Froggy111/RBC-soccer-2025/README.md

# RBC-soccer-2025

(Currently internal) Repository for 2025 RCJ Soccer Lightweight team from RI.

Other Links:
- Component spreadsheet: https://docs.google.com/spreadsheets/d/1nkJU1fMwBykuh6vTQhCEh5VCzHdAhULuCZyUjWnpDP0/edit#gid=0
