Froggy111/RBC-soccer-2025/hardware/mirror/README.md

# Mirror Generator

generate slice:
```./main.o 80 150 2430 30 10000 100 1 1000 1000```
generate stl:
```./src/main.o 80 150 2430 30 100 1000 1 100 mirror.stl generated_by_mirror```

Numerical solver for mirror geometry. Generates mirror stl (TODO: add an inset to make it a proper mirror mold)
