Froggy111/RBC-soccer-2025/software/top/README.md

# top PCB firmware

## project structure

drivers/libraries are in libs/
main executables are in src/
tests of drivers/libraries/basic functionality are in tests/
configs are in configs/

## used libraries

- PicoSDK
- TinyUSB
- FreeRTOS
