Froggy111/RBC-soccer-2025/software/middle/goalpost_detection/blue1.png

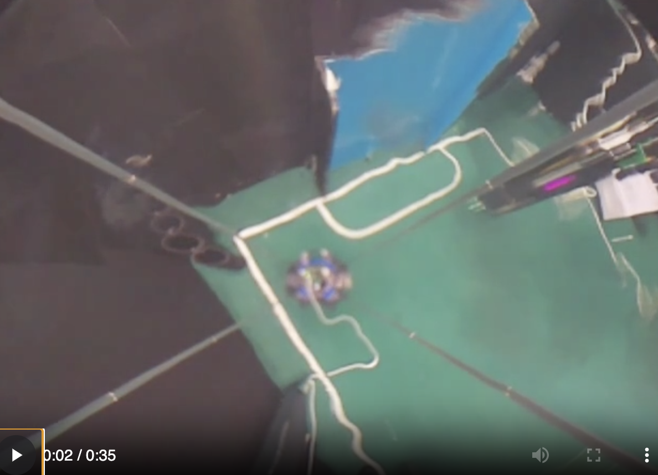
software/middle/goalpost_detection/blue1.png
