Froggy111/RBC-soccer-2025/software/rpi-direct/field.png

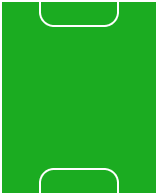
software/rpi-direct/field.png
