Froggy111/RBC-soccer-2025/hardware/lightgate/pcb/pcb.step

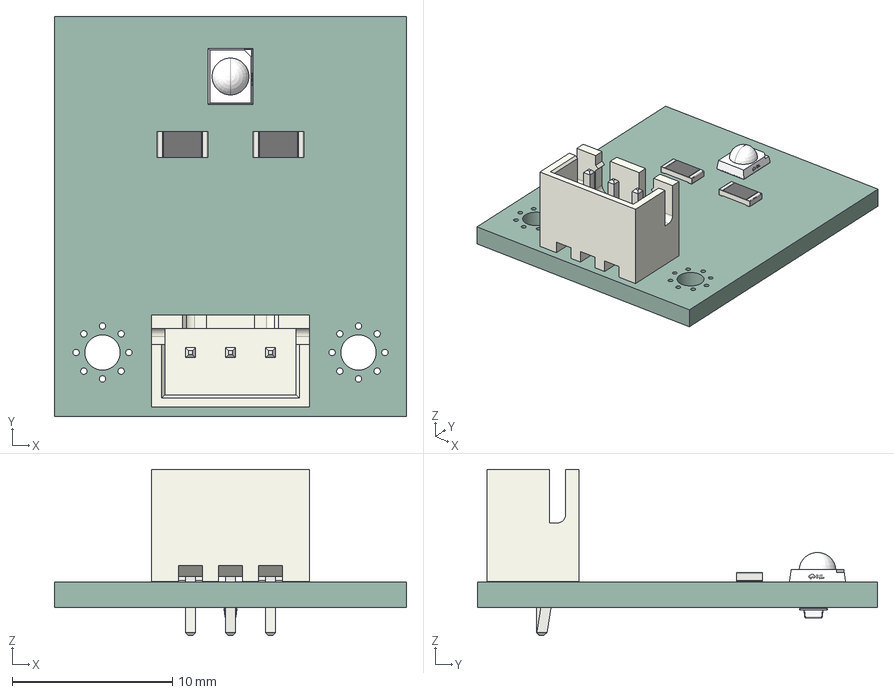
[picture p7: CAD file, 2025-02-17]
hardware/lightgate/pcb/pcb.step
22.0 x 25.0 x 10.4 mm
LED-SMD_L3.5-W2.8_JNJ-LTJH0111W60
R_1206_3216Metric x 2
JST_B3B_XH_A
SENSORS-SMD_L1.7-W0.8-H0.6
pcb_PCB
