Froggy111/RBC-soccer-2025/hardware/mouse-sensor/pcb/pcb-Edge_Cuts.dxf

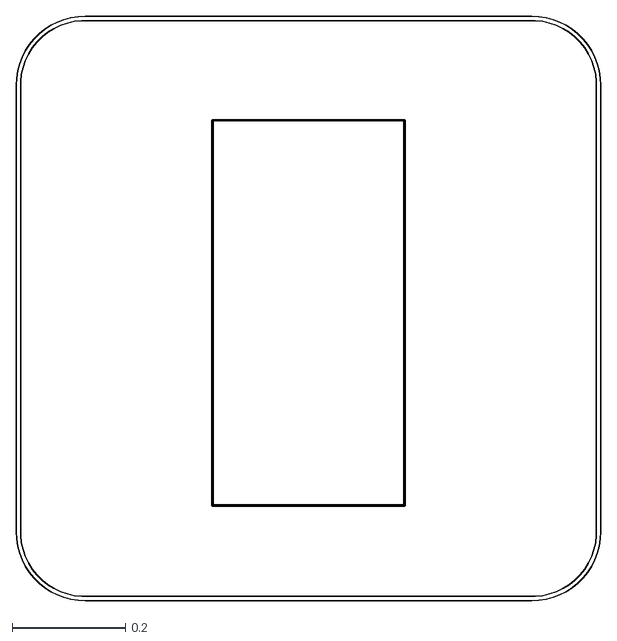
[picture p8: CAD file, 2024-12-10]
hardware/mouse-sensor/pcb/pcb-Edge_Cuts.dxf
1.03 x 1.03
