Froggy111/RBC-soccer-2025/hardware/ultrasound/pcb/pcb.step

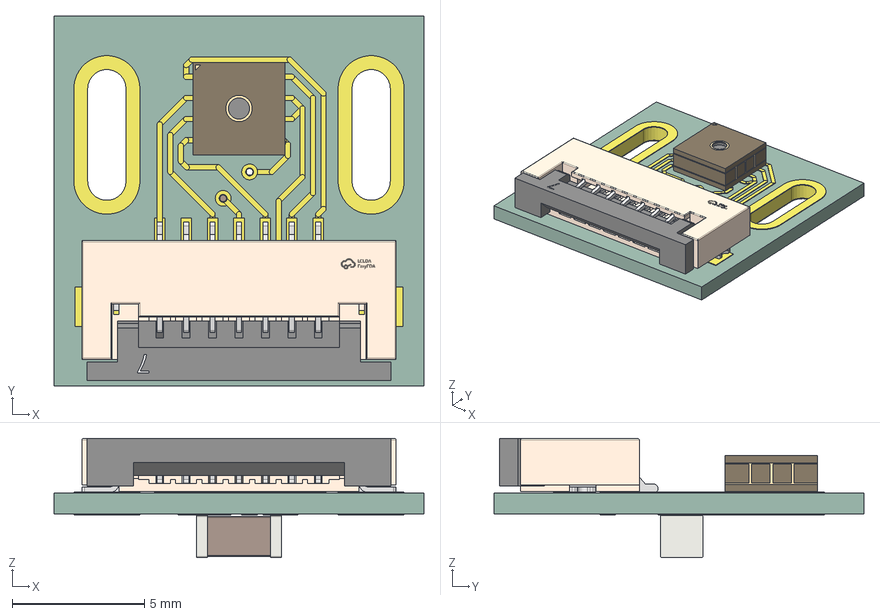
[picture p9: CAD file, 2025-01-07]
hardware/ultrasound/pcb/pcb.step
14.0 x 14.0 x 4.51 mm
CH201-00ABR
FPC-SMD_7P-P1.0_KINGHELM_KH-FG1.0-H2.0-7PIN
C_1206_3216Metric
pcb_track_1
pcb_track_2
pcb_track_3
pcb_track_4
pcb_track_5
pcb_track_6
pcb_track_7
pcb_track_8
pcb_track_9
pcb_track_10
pcb_track_11
pcb_track_12
pcb_track_13
pcb_track_14
pcb_track_15
pcb_track_16
pcb_track_17
pcb_track_18
pcb_track_19
pcb_track_20
pcb_track_21
pcb_track_22
pcb_track_23
pcb_track_24
pcb_track_25
pcb_track_26
pcb_track_27
pcb_track_28
pcb_track_29
pcb_track_30
pcb_track_31
pcb_track_32
pcb_track_33
pcb_track_34
pcb_track_35
pcb_track_36
pcb_track_37
pcb_track_38
pcb_track_39
pcb_track_40
pcb_track_41
pcb_track_42
pcb_track_43
pcb_track_44
pcb_track_45
pcb_track_46
pcb_track_47
pcb_track_48
pcb_pad_1
pcb_pad_2
pcb_pad_3
pcb_pad_4
pcb_pad_5
pcb_pad_6
pcb_pad_7
pcb_pad_8
pcb_pad_9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
