Froggy111/RBC-soccer-2025/TODO.md

**THIS IS QUITE USELESS. JUST HERE TO PRESERVE STRUCTURE OF THIS REPO**

TBC = have not thought about enough yet to have a solid plan. Fill up in the future.
**THIS IS A REMINDER TO FILL UP IF YOU ARE LOOKING AT THIS, IF YOU CAN**

**REFER TO SUBDIRs FOR SPECIFICS.**

Thread 1:
- Do hardware tests, prototype seperate parts (refer to hardware TODO).

Thread 2:
- Design software structure, write code (refer to software TODO).
