Froggy111/RBC-soccer-2025/software/TODO.md

TBC = have not thought about enough yet to have a solid plan. Fill up in the future.
<ins>**_THIS IS A REMINDER TO FILL UP IF YOU ARE LOOKING AT THIS, IF YOU CAN_**</ins>

<ins>**Mostly completed:**</ins>

<ins>**Incomplete:**</ins>
**(TBC) Thread 1:**
- Hardware interfacing

**(TBC) Thread 2:**
- Hardware data to useful software data (algos, can do first)

**(TBC) Thread 3:**
- Strategy (can also do first)
