Froggy111/RBC-soccer-2025/hardware/lightgate/pcb/pcb.kicad_pcb

## KiCad design hardware/lightgate/pcb/pcb.kicad_pcb (2025-02-17)

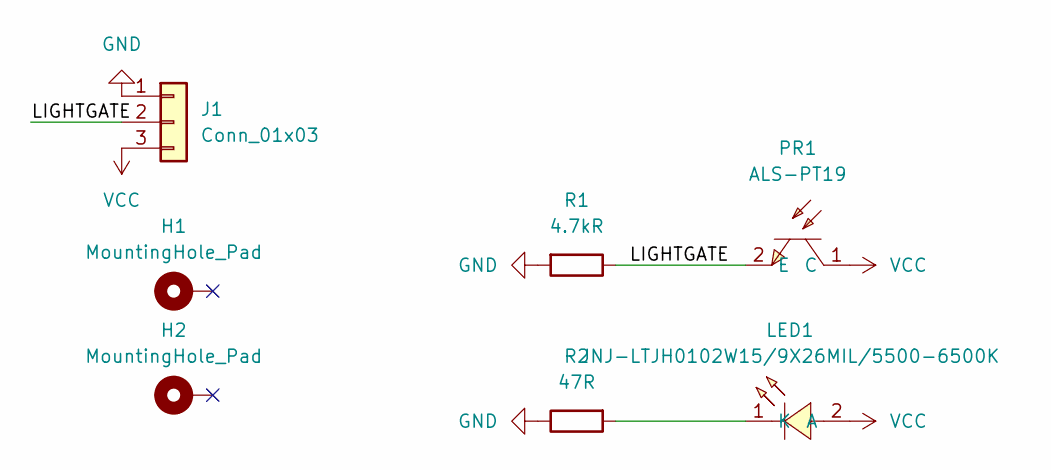
[picture p10: schematic pcb.kicad_sch]

Parts:
H1, H2: MountingHole_Pad; MountingHole_2.2mm_M2_Pad_Via
J1: Conn_01x03; JST_XH_B3B-XH-A_1x03_P2.50mm_Vertical
LED1: JNJ-LTJH0102W15/9X26MIL/5500-6500K; LED-SMD_L3.5-W2.8_JNJ-LTJH0111W60; LCSC Part C7500117
PR1: ALS-PT19; SENSORS-SMD_ALS-PT19; LCSC Part C146233
R1: 4.7kR; R_1206_3216Metric_Pad1.30x1.75mm_HandSolder
R2: 47R; R_1206_3216Metric_Pad1.30x1.75mm_HandSolder

Connections:
/LIGHTGATE: J1.2, PR1.2 (E), R1.1
GND: J1.1, R1.2, R2.1
unnamed: LED1.1 (K), R2.2
VCC: J1.3, LED1.2 (A), PR1.1 (C)

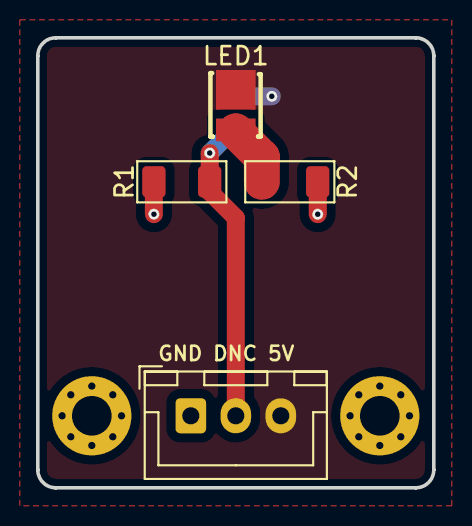
[picture p11: board hardware/lightgate/pcb/pcb.kicad_pcb from above]

Board: 2 copper layers, 22.0 x 25.0 mm, 7 parts (1 on the bottom side), 4 nets.
