Froggy111/RBC-soccer-2025/hardware/kicker/pcb/pcb.kicad_pcb

## KiCad design hardware/kicker/pcb/pcb.kicad_pcb (2025-02-16)

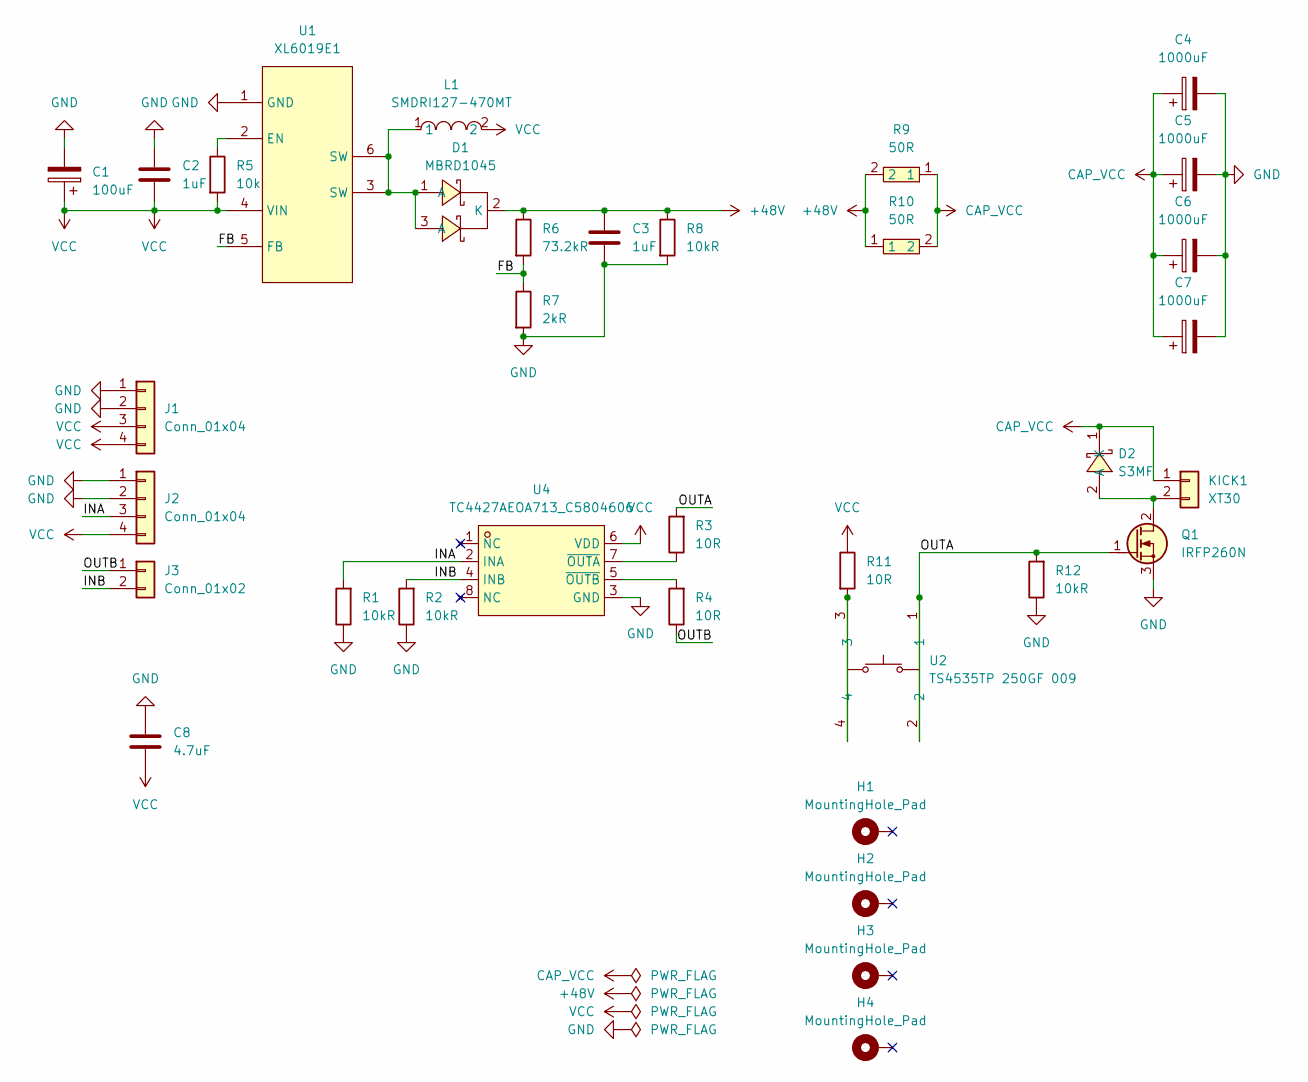
[picture p12: schematic pcb.kicad_sch]

Parts:
C1: 100uF; CP_Elec_6.3x7.7
C2, C3: 1uF; C_1206_3216Metric_Pad1.33x1.80mm_HandSolder
C4, C5, C6, C7: 1000uF; CAP-TH_BD13.0-P5.00-D1.2-FD
C8: 4.7uF; C_1206_3216Metric_Pad1.33x1.80mm_HandSolder
D1: MBRD1045; TO-252-3_L6.5-W5.9-P4.60-LS10.0-BL; LCSC Part C5137764
D2: S3MF; SMAF_L3.5-W2.6-LS4.7-RD-1; LCSC Part C18199092
H1, H2, H3, H4: MountingHole_Pad; MountingHole_2.2mm_M2_Pad_Via
J1, J2: Conn_01x04; PinHeader_1x04_P2.54mm_Vertical
J3: Conn_01x02; JST_PH_B2B-PH-K_1x02_P2.00mm_Vertical
KICK1: XT30; AMASS_XT30U-F_1x02_P5.0mm_Vertical
L1: SMDRI127-470MT; IND-SMD_L12.3-W12.3; LCSC Part C9906
Q1: IRFP260N; TO-247-3_Vertical_GDS
R1, R2, R8, R12: 10kR; R_1206_3216Metric_Pad1.30x1.75mm_HandSolder
R3, R4, R11: 10R; R_1206_3216Metric_Pad1.30x1.75mm_HandSolder
R5: 10k; R_1206_3216Metric_Pad1.30x1.75mm_HandSolder
R6: 73.2kR; R_1206_3216Metric_Pad1.30x1.75mm_HandSolder
R7: 2kR; R_1206_3216Metric_Pad1.30x1.75mm_HandSolder
R9, R10: 50R; TO-220-2L_L10.2-W4.6-P5.08-L; LCSC Part C5209737
U1: XL6019E1; TO-263-5_L10.2-W9.9-P1.70-LS14.4-TL; LCSC Part C73018
U2: TS4535TP 250GF 009; SW-SMD_4P-L4.5-W4.5-P3.00-LS6.8; LCSC Part C5342982
U4: TC4427AEOA713_C5804606; SOIC-8_L4.9-W3.9-P1.27-LS6.0-BL; LCSC Part C5804606

Connections:
+48V: C3.1, D1.2 (K), R6.1, R8.1, R9.2, R10.1
/FB: R6.2, R7.1, U1.5 (FB)
/INA: J2.3, R1.2, U4.2 (INA)
/INB: J3.2, R2.2, U4.4 (INB)
/OUTA: Q1.1 (G), R3.2, R12.2, U2.1, U2.2
/OUTB: J3.1, R4.1
CAP_VCC: C4.1, C5.1, C6.1, C7.1, D2.1 (K), KICK1.1, R9.1, R10.2
GND: C1.2, C2.1, C3.2, C4.2, C5.2, C6.2, C7.2, C8.1, J1.1, J1.2, J2.1, J2.2, Q1.3 (S), R1.1, R2.1, R7.2, R8.2, R12.1, U1.1 (GND), U4.3 (GND)
unnamed: D1.1 (A), D1.3 (A), L1.1, U1.3 (SW), U1.6 (SW)
unnamed: D2.2 (A), KICK1.2, Q1.2 (D)
unnamed: R11.2, U2.3, U2.4
unnamed: R5.1, U1.2 (EN)
unnamed: R3.1, U4.7 (~OUTA)
unnamed: R4.2, U4.5 (~OUTB)
VCC: C1.1, C2.2, C8.2, J1.3, J1.4, J2.4, L1.2, R5.2, R11.1, U1.4 (VIN), U4.6 (VDD)

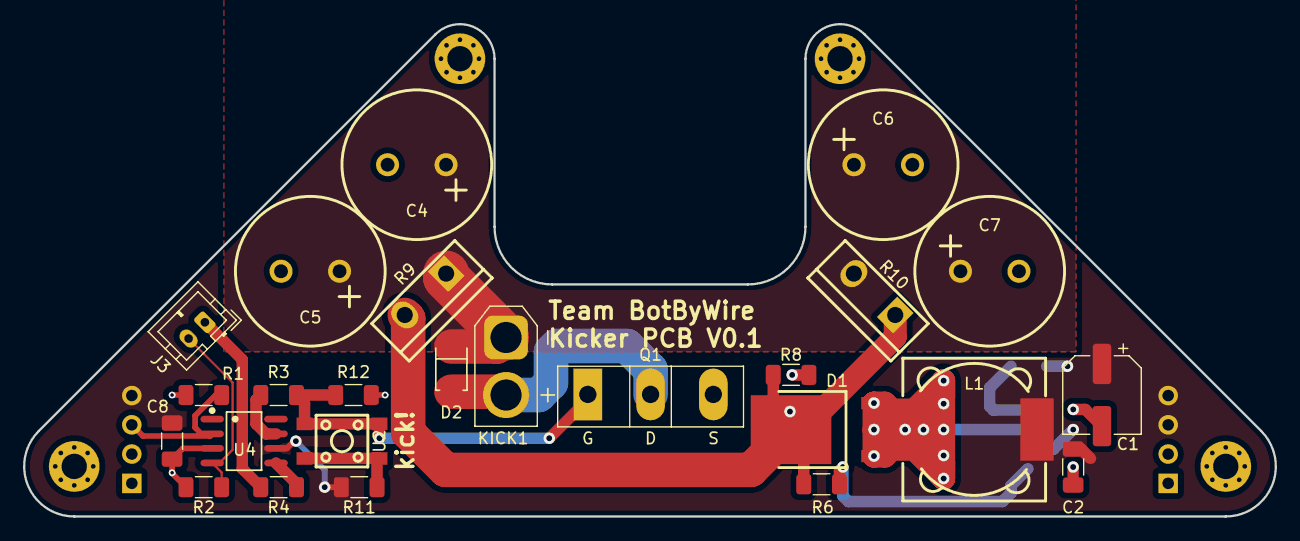
[picture p13: board hardware/kicker/pcb/pcb.kicad_pcb from above]

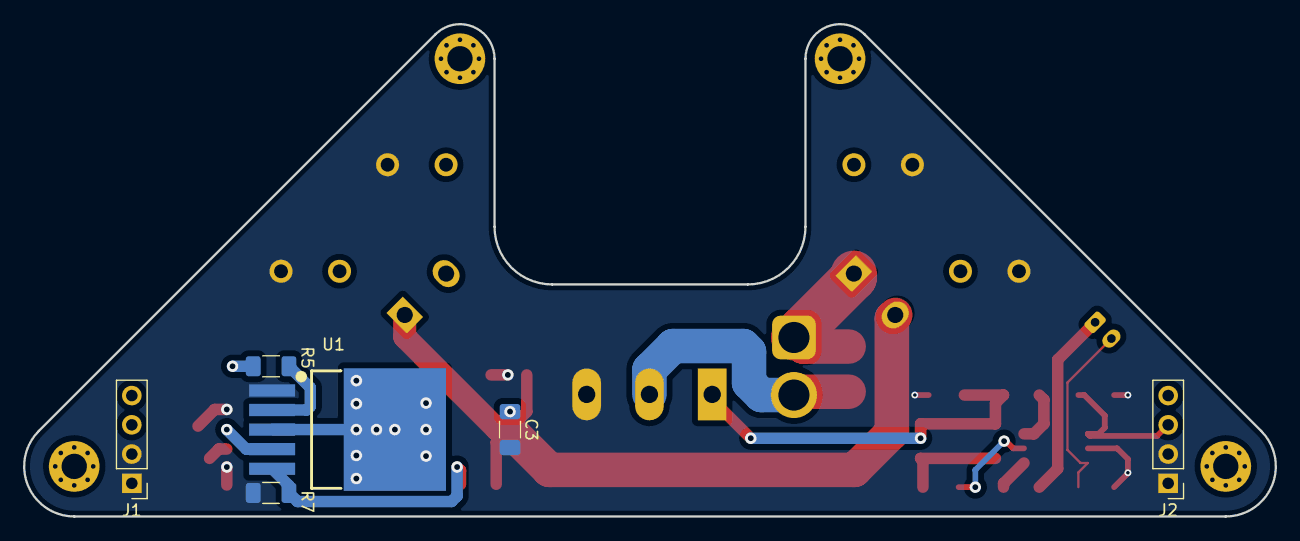
[picture p14: board hardware/kicker/pcb/pcb.kicad_pcb from below]

Board: 2 copper layers, 108.7 x 42.8 mm, 35 parts (6 on the bottom side), 15 nets.
