Froggy111/RBC-soccer-2025/hardware/top-plate/pcb/pcb.kicad_pcb

## KiCad design hardware/top-plate/pcb/pcb.kicad_pcb (2025-02-08)

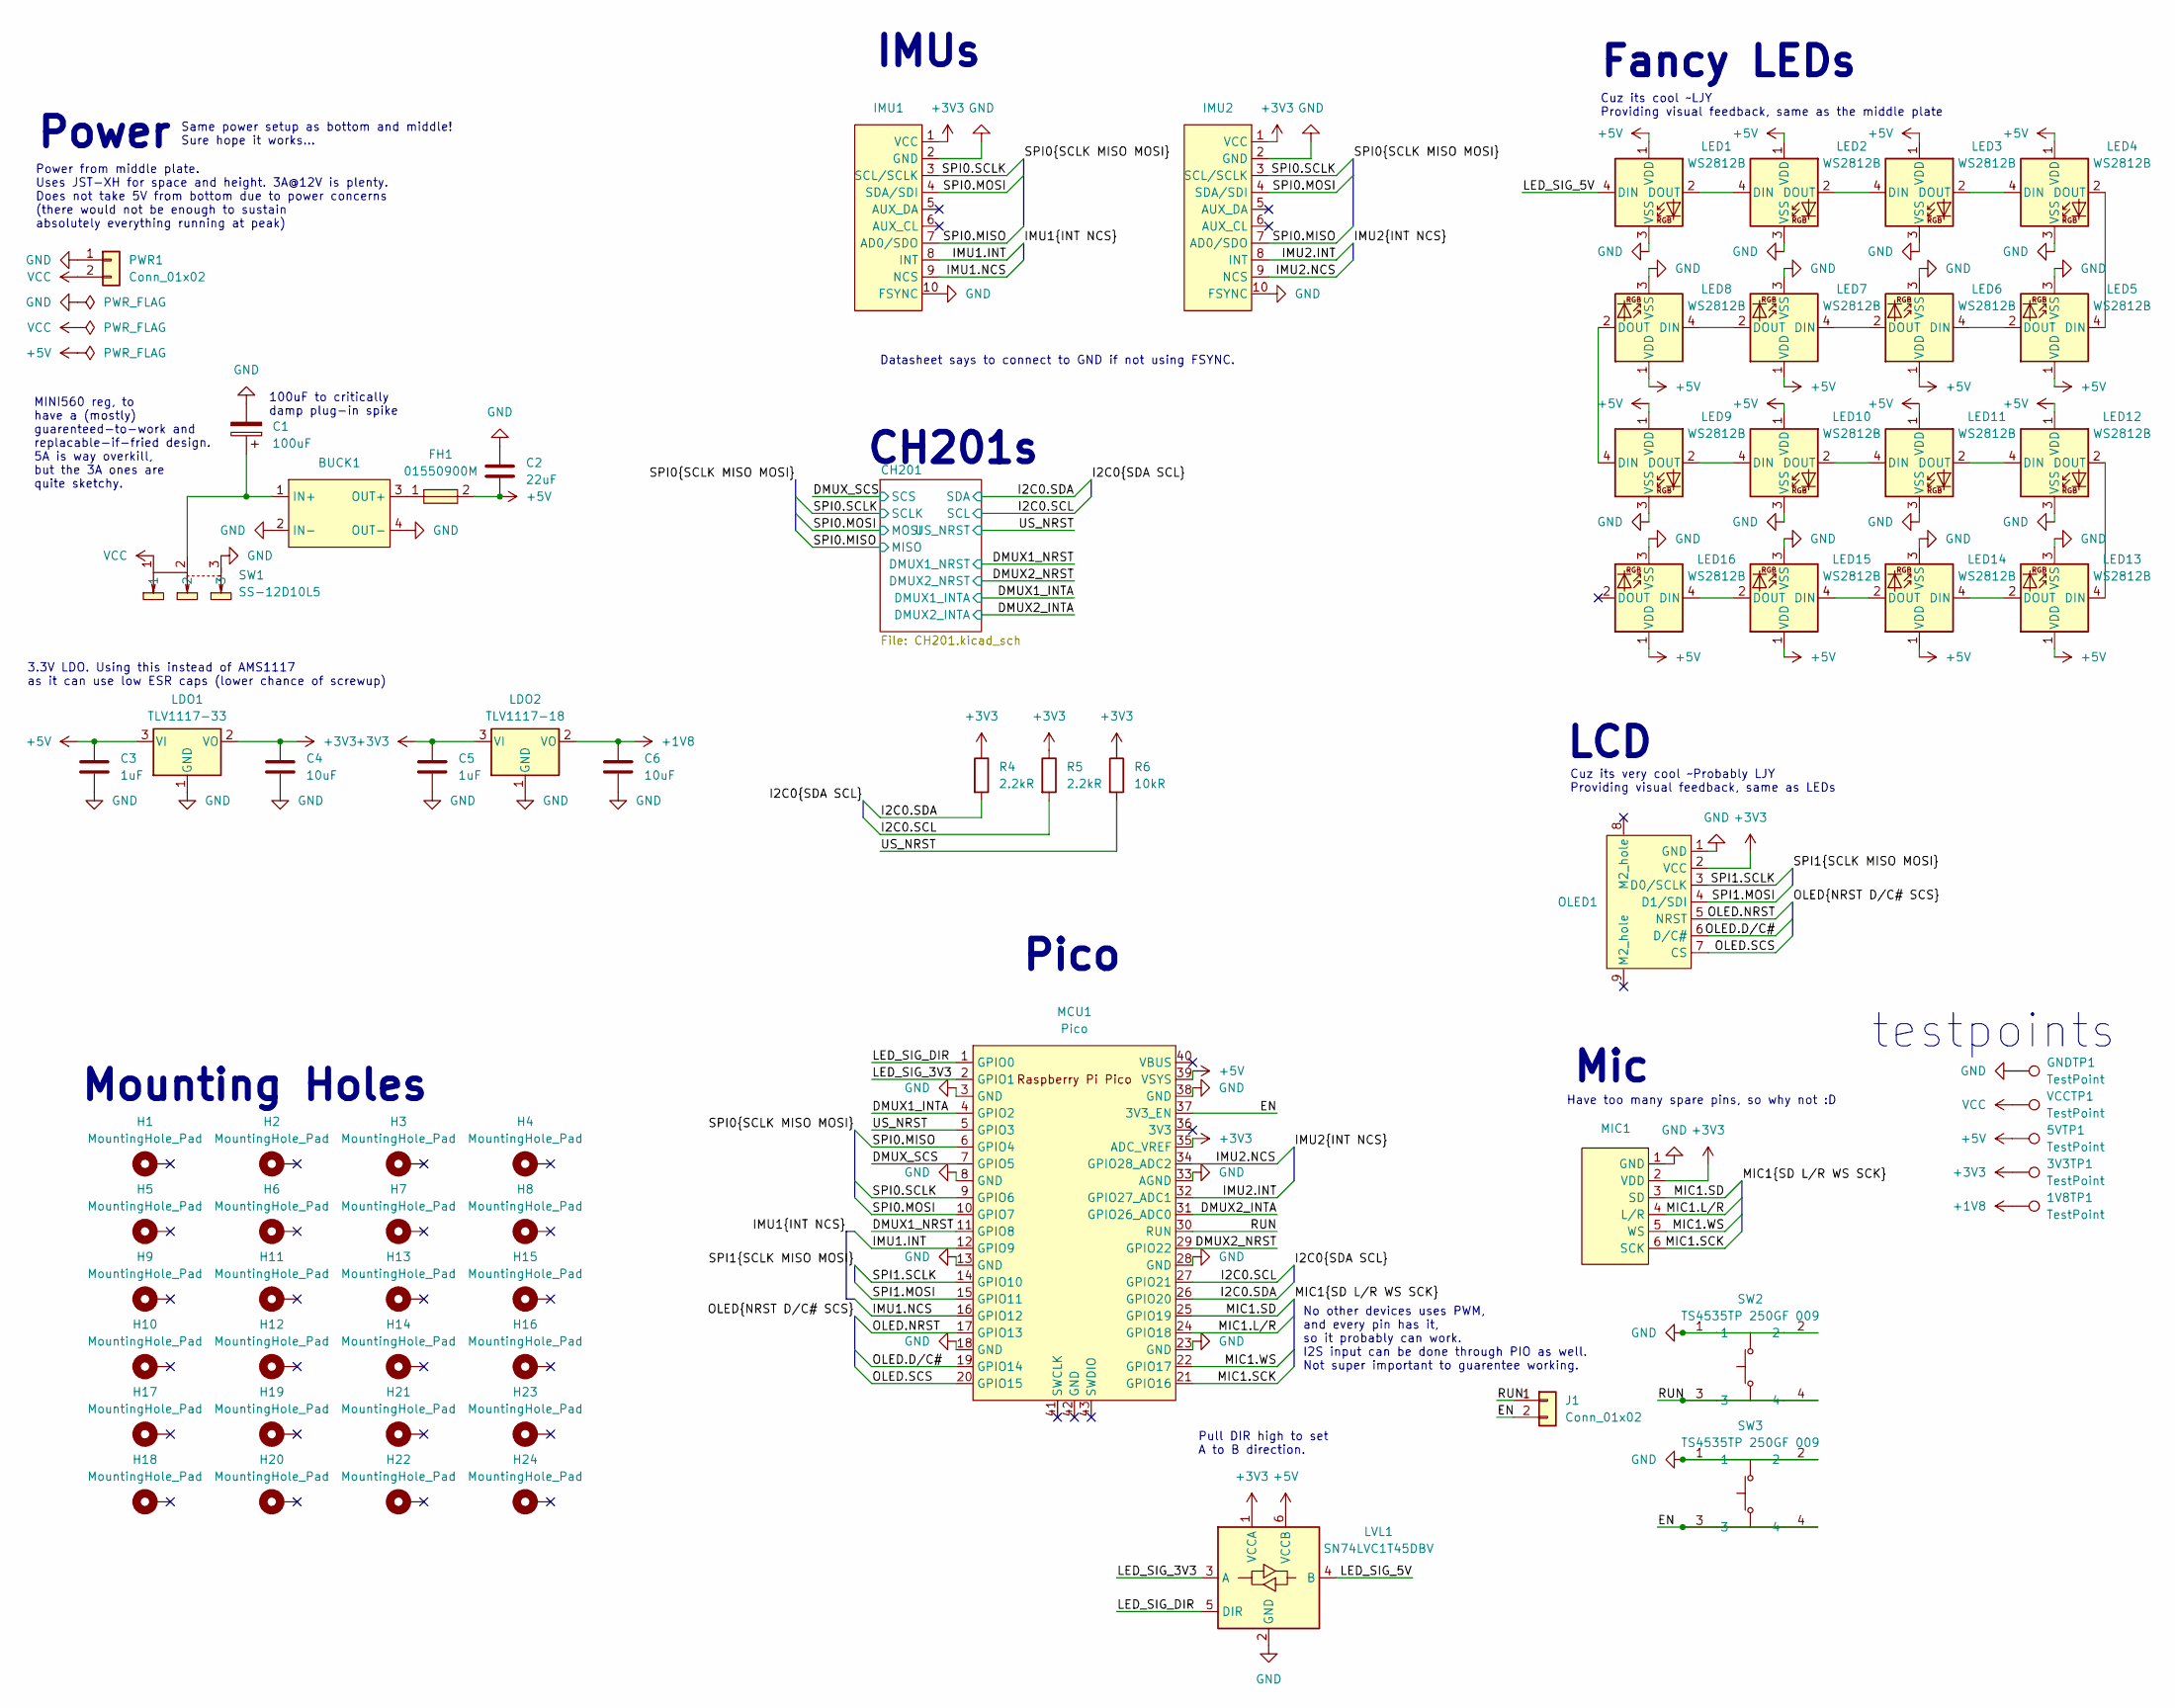
[picture p15: schematic pcb.kicad_sch]

Parts:
1V8TP1, 3V3TP1, 5VTP1: TestPoint; TestPoint_THTPad_D1.0mm_Drill0.5mm
BUCK1: mini560
C1: 100uF; CP_Elec_6.3x7.7
C2: 22uF; C_0805_2012Metric_Pad1.15x1.40mm_HandSolder
C3, C5: 1uF; C_0805_2012Metric_Pad1.15x1.40mm_HandSolder
C4, C6: 10uF; C_0805_2012Metric_Pad1.15x1.40mm_HandSolder
FH1: 01550900M; FUSE-SMD_L9.8-W5.0; LCSC Part C108518
GNDTP1: TestPoint; TestPoint_THTPad_D1.0mm_Drill0.5mm
H1, H2, H3, H4, H5, H6, H7, H8, H9, H10, H11, H12, H13, H14, H15, H16, H17, H18, H19, H20, H21, H22, H23, H24: MountingHole_Pad; MountingHole_2.2mm_M2_Pad_Via
IMU1, IMU2: ICM20948-no-mountingholes
J1: Conn_01x02; JST_XH_B2B-XH-A_1x02_P2.50mm_Vertical
LDO1: TLV1117-33; SOT-223-3_TabPin2
LDO2: TLV1117-18; SOT-223-3_TabPin2
LED1, LED2, LED3, LED4, LED5, LED6, LED7, LED8, LED9, LED10, LED11, LED12, LED13, LED14, LED15, LED16: WS2812B; LED_WS2812B_PLCC4_5.0x5.0mm_P3.2mm
LVL1: SN74LVC1T45DBV; SOT-23-6
MCU1: Pico; RPi_Pico_SMD_TH_USBC_cable_cutout
MIC1: INMP441_SMD
OLED1: 0.96-inch_OLED_7-no-back-mountingholes
PWR1: Conn_01x02; JST_XH_B2B-XH-A_1x02_P2.50mm_Vertical
R4, R5: 2.2kR; R_0805_2012Metric_Pad1.15x1.40mm_HandSolder
R6: 10kR; R_0805_2012Metric_Pad1.15x1.40mm_HandSolder
SW1: SS-12D10L5; SW-TH_SS-12D10L5; LCSC Part C319012
SW2, SW3: TS4535TP 250GF 009; SW-SMD_4P-L4.5-W4.5-P3.00-LS6.8; LCSC Part C5342982
VCCTP1: TestPoint; TestPoint_THTPad_D1.0mm_Drill0.5mm

Connections:
+1V8: 1V8TP1.1, C6.2, LDO2.2 (VO); also elsewhere on the board
+3V3: 3V3TP1.1, C4.2, C5.2, IMU1.1 (VCC), IMU2.1 (VCC), LDO1.2 (VO), LDO2.3 (VI), LVL1.1 (VCCA), MCU1.35 (ADC_VREF), MIC1.2 (VDD), OLED1.2 (VCC), R4.1, R5.1, R6.1; also elsewhere on the board
+5V: 5VTP1.1, C2.2, C3.2, FH1.2, LDO1.3 (VI), LED1.1 (VDD), LED2.1 (VDD), LED3.1 (VDD), LED4.1 (VDD), LED5.1 (VDD), LED6.1 (VDD), LED7.1 (VDD), LED8.1 (VDD), LED9.1 (VDD), LED10.1 (VDD), LED11.1 (VDD), LED12.1 (VDD), LED13.1 (VDD), LED14.1 (VDD), LED15.1 (VDD), LED16.1 (VDD), LVL1.6 (VCCB), MCU1.39 (VSYS)
/DMUX1_INTA: MCU1.4 (GPIO2); also elsewhere on the board
/DMUX1_NRST: MCU1.11 (GPIO8); also elsewhere on the board
/DMUX2_INTA: MCU1.31 (GPIO26_ADC0); also elsewhere on the board
/DMUX2_NRST: MCU1.29 (GPIO22); also elsewhere on the board
/DMUX_SCS: MCU1.7 (GPIO5); also elsewhere on the board
/EN: J1.2, MCU1.37 (3V3_EN), SW3.3, SW3.4
/I2C0.SCL: MCU1.27 (GPIO21), R5.2; also elsewhere on the board
/I2C0.SDA: MCU1.26 (GPIO20), R4.2; also elsewhere on the board
/IMU1.INT: IMU1.8 (INT), MCU1.12 (GPIO9)
/IMU1.NCS: IMU1.9 (NCS), MCU1.16 (GPIO12)
/IMU2.INT: IMU2.8 (INT), MCU1.32 (GPIO27_ADC1)
/IMU2.NCS: IMU2.9 (NCS), MCU1.34 (GPIO28_ADC2)
/LED_SIG_3V3: LVL1.3 (A), MCU1.2 (GPIO1)
/LED_SIG_5V: LED1.4 (DIN), LVL1.4 (B)
/LED_SIG_DIR: LVL1.5 (DIR), MCU1.1 (GPIO0)
/MIC1.L/R: MCU1.24 (GPIO18), MIC1.4 (L/R)
/MIC1.SCK: MCU1.21 (GPIO16), MIC1.6 (SCK)
/MIC1.SD: MCU1.25 (GPIO19), MIC1.3 (SD)
/MIC1.WS: MCU1.22 (GPIO17), MIC1.5 (WS)
/OLED.D/C#: MCU1.19 (GPIO14), OLED1.6 (D/C#)
/OLED.NRST: MCU1.17 (GPIO13), OLED1.5 (NRST)
/OLED.SCS: MCU1.20 (GPIO15), OLED1.7 (CS)
/RUN: J1.1, MCU1.30 (RUN), SW2.3, SW2.4
/SPI0.MISO: IMU1.7 (AD0/SDO), IMU2.7 (AD0/SDO), MCU1.6 (GPIO4); also elsewhere on the board
/SPI0.MOSI: IMU1.4 (SDA/SDI), IMU2.4 (SDA/SDI), MCU1.10 (GPIO7); also elsewhere on the board
/SPI0.SCLK: IMU1.3 (SCL/SCLK), IMU2.3 (SCL/SCLK), MCU1.9 (GPIO6); also elsewhere on the board
/SPI1.MOSI: MCU1.15 (GPIO11), OLED1.4 (D1/SDI)
/SPI1.SCLK: MCU1.14 (GPIO10), OLED1.3 (D0/SCLK)
/US_NRST: MCU1.5 (GPIO3), R6.2; also elsewhere on the board
GND: BUCK1.2 (IN-), BUCK1.4 (OUT-), C1.2, C2.1, C3.1, C4.1, C5.1, C6.1, GNDTP1.1, IMU1.2 (GND), IMU1.10 (FSYNC), IMU2.2 (GND), IMU2.10 (FSYNC), LDO1.1 (GND), LDO2.1 (GND), LED1.3 (VSS), LED2.3 (VSS), LED3.3 (VSS), LED4.3 (VSS), LED5.3 (VSS), LED6.3 (VSS), LED7.3 (VSS), LED8.3 (VSS), LED9.3 (VSS), LED10.3 (VSS), LED11.3 (VSS), LED12.3 (VSS), LED13.3 (VSS), LED14.3 (VSS), LED15.3 (VSS), LED16.3 (VSS), LVL1.2 (GND), MCU1.3 (GND), MCU1.8 (GND), MCU1.13 (GND), MCU1.18 (GND), MCU1.23 (GND), MCU1.28 (GND), MCU1.33 (AGND), MCU1.38 (GND), MIC1.1 (GND), OLED1.1 (GND), PWR1.1, SW1.3, SW2.1, SW2.2, SW3.1, SW3.2; also elsewhere on the board
unnamed: BUCK1.1 (IN+), C1.1, SW1.2
unnamed: BUCK1.3 (OUT+), FH1.1
unnamed: LED1.2 (DOUT), LED2.4 (DIN)
unnamed: LED2.2 (DOUT), LED3.4 (DIN)
unnamed: LED3.2 (DOUT), LED4.4 (DIN)
unnamed: LED4.2 (DOUT), LED5.4 (DIN)
unnamed: LED5.2 (DOUT), LED6.4 (DIN)
unnamed: LED6.2 (DOUT), LED7.4 (DIN)
unnamed: LED7.2 (DOUT), LED8.4 (DIN)
unnamed: LED8.2 (DOUT), LED9.4 (DIN)
unnamed: LED9.2 (DOUT), LED10.4 (DIN)
unnamed: LED10.2 (DOUT), LED11.4 (DIN)
unnamed: LED11.2 (DOUT), LED12.4 (DIN)
unnamed: LED12.2 (DOUT), LED13.4 (DIN)
unnamed: LED13.2 (DOUT), LED14.4 (DIN)
unnamed: LED14.2 (DOUT), LED15.4 (DIN)
unnamed: LED15.2 (DOUT), LED16.4 (DIN)
VCC: PWR1.2, SW1.1, VCCTP1.1

Notes on the sheet:
CH201s
IMUs
No other devices uses PWM, and every pin has it, so it probably can work. I2S input can be done through PIO as well. Not super important to guarentee working.
MINI560 reg, to have a (mostly) guarenteed-to-work and replacable-if-fried design. 5A is way overkill, but the 3A ones are quite sketchy.
Same power setup as bottom and middle! Sure hope it works...
Cuz its very cool ~Probably LJY Providing visual feedback, same as LEDs
Fancy LEDs
3.3V LDO. Using this instead of AMS1117 as it can use low ESR caps (lower chance of screwup)
Datasheet says to connect to GND if not using FSYNC.
Pull DIR high to set A to B direction.
Have too many spare pins, so why not :D
Cuz its cool ~LJY Providing visual feedback, same as the middle plate
Power
Pico
Power from middle plate. Uses JST-XH for space and height. 3A@12V is plenty. Does not take 5V from bottom due to power concerns (there would not be enough to sustain absolutely everything running at peak)
100uF to critically damp plug-in spike
Mic
LCD
Mounting Holes
testpoints

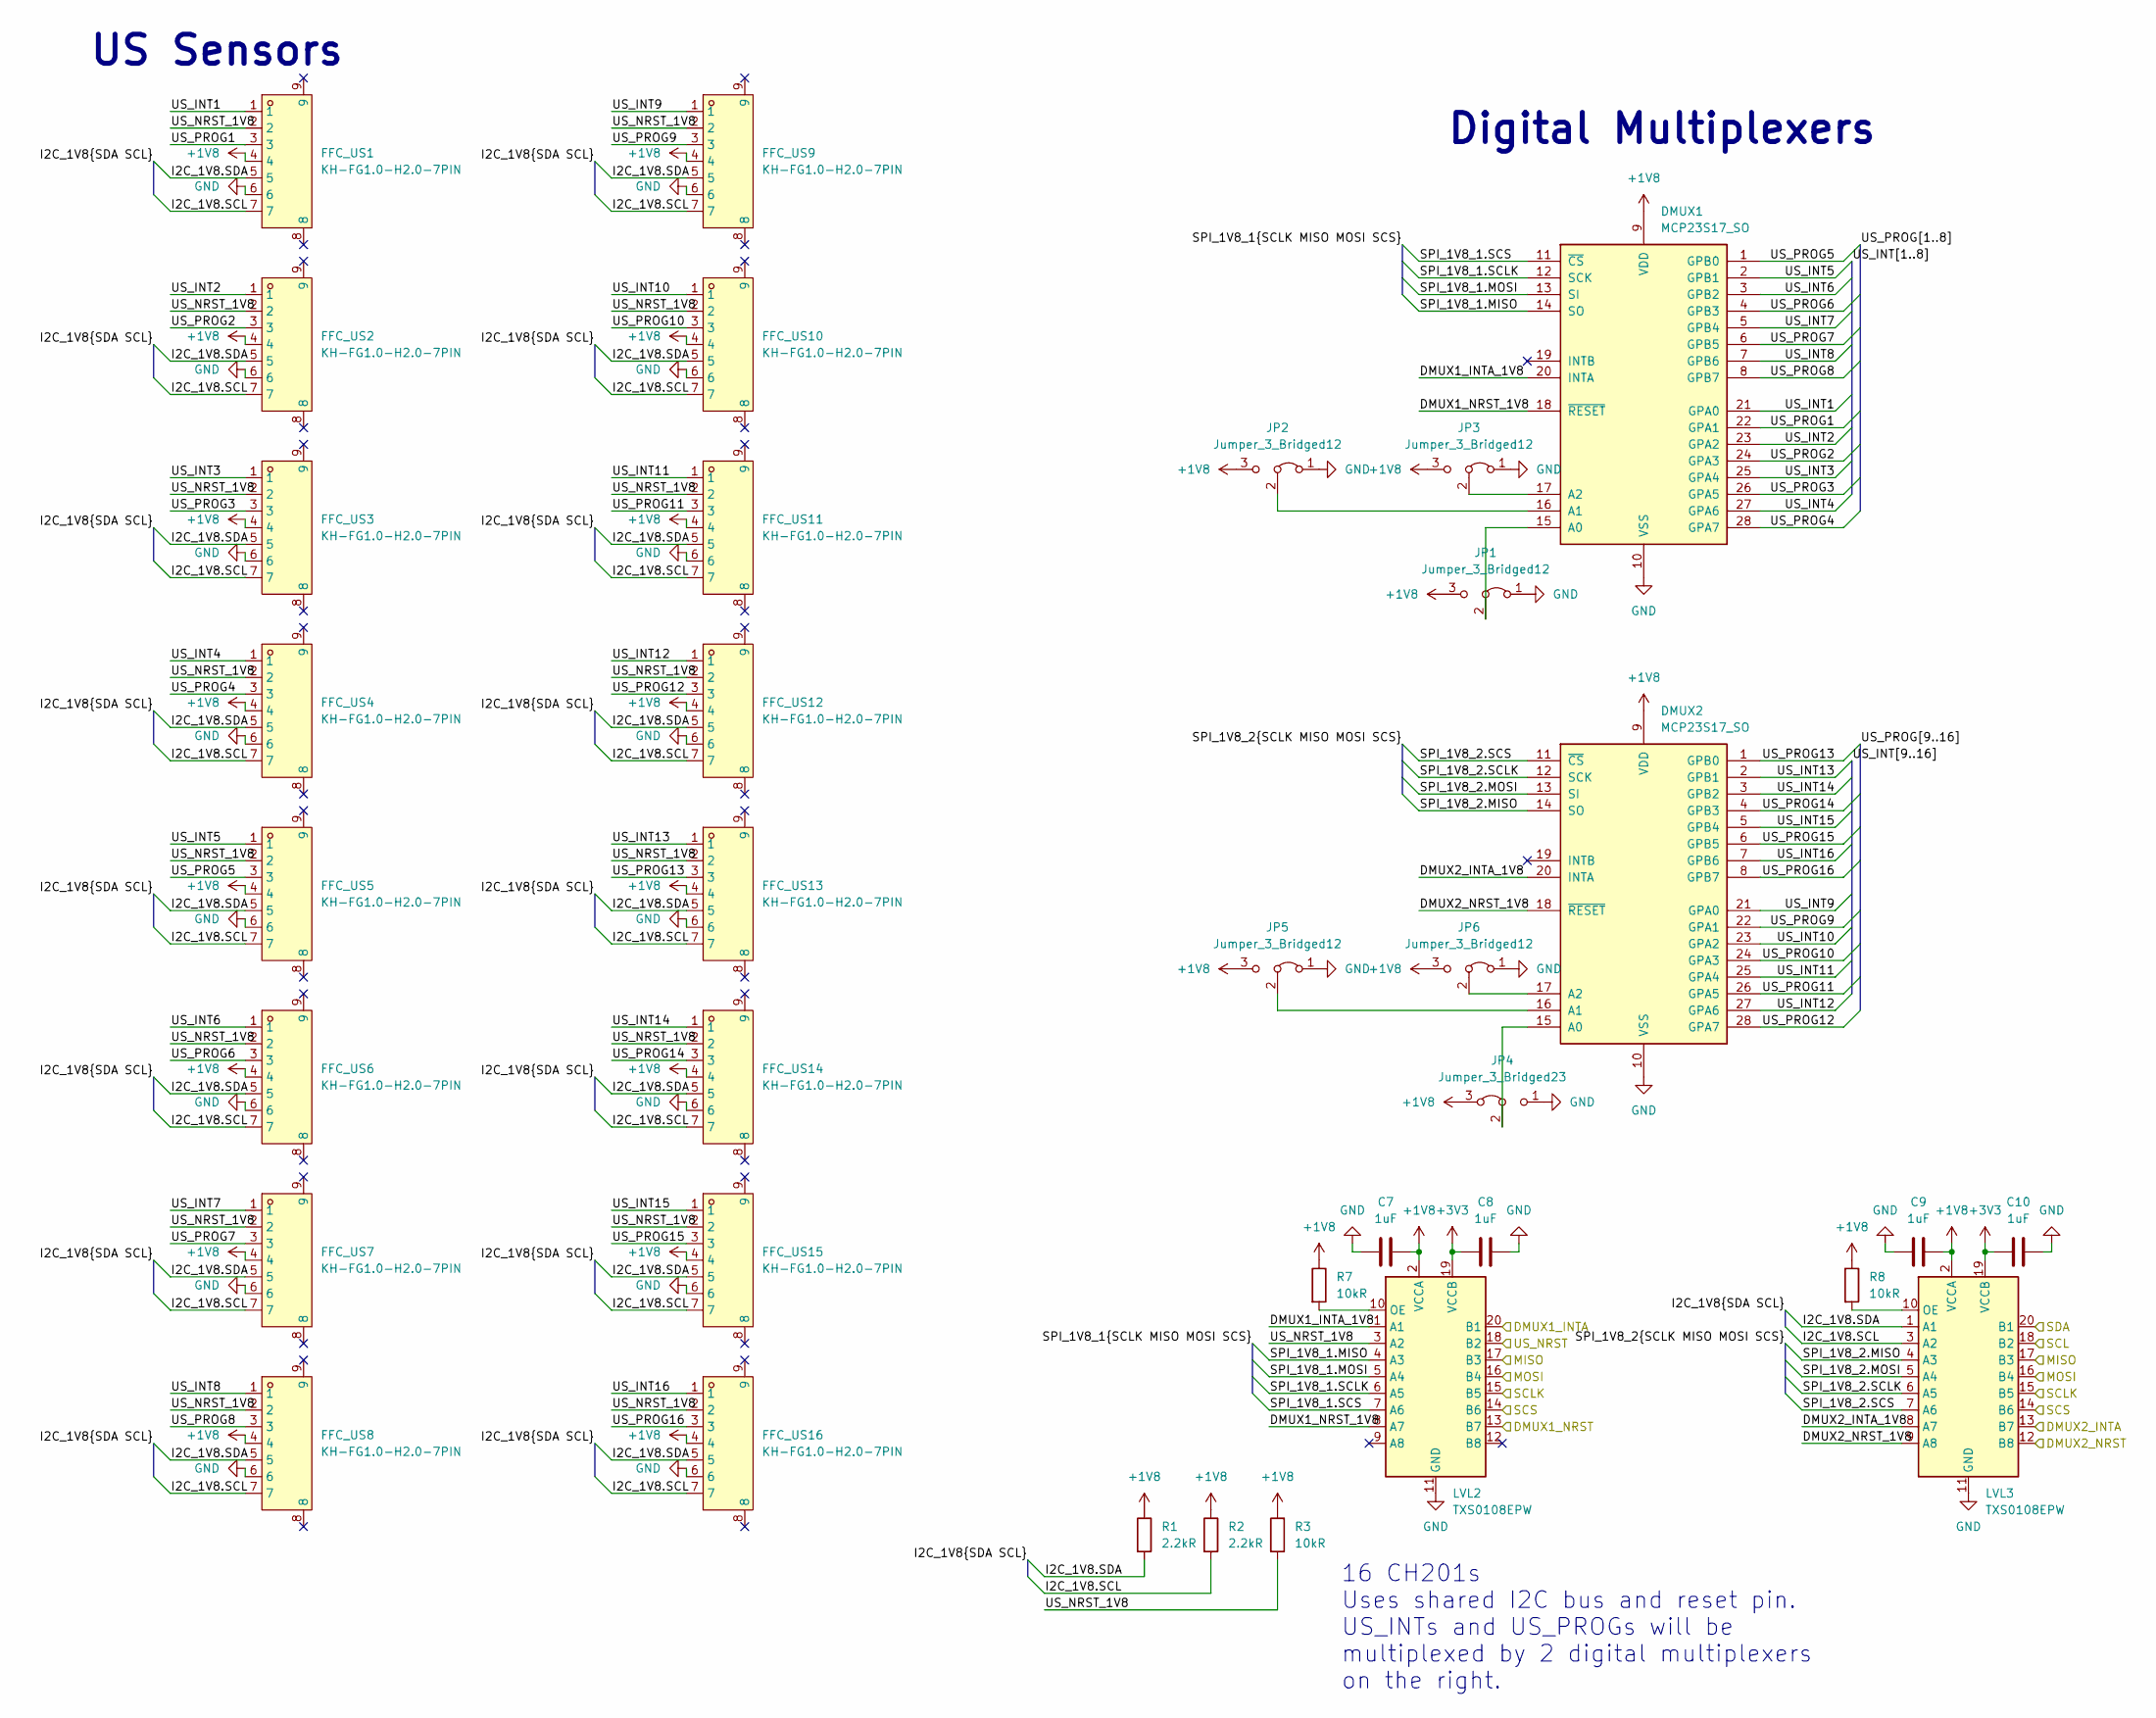
[picture p16: schematic CH201.kicad_sch]

Parts:
C7, C8, C9, C10: 1uF; C_0805_2012Metric_Pad1.15x1.40mm_HandSolder
DMUX1, DMUX2: MCP23S17_SO; SOIC-28W_7.5x17.9mm_P1.27mm
FFC_US1, FFC_US2, FFC_US3, FFC_US4, FFC_US5, FFC_US6, FFC_US7, FFC_US8, FFC_US9, FFC_US10, FFC_US11, FFC_US12, FFC_US13, FFC_US14, FFC_US15, FFC_US16: KH-FG1.0-H2.0-7PIN; FPC-SMD_7P-P1.0_KINGHELM_KH-FG1.0-H2.0-7PIN; LCSC Part C2925379
JP1, JP2, JP3, JP5, JP6: Jumper_3_Bridged12; PinHeader_1x03_P1.27mm_Vertical
JP4: Jumper_3_Bridged23; PinHeader_1x03_P1.27mm_Vertical
LVL2, LVL3: TXS0108EPW; TSSOP-20_4.4x6.5mm_P0.65mm
R1, R2: 2.2kR; R_0805_2012Metric_Pad1.15x1.40mm_HandSolder
R3, R7, R8: 10kR; R_0805_2012Metric_Pad1.15x1.40mm_HandSolder

Connections:
+1V8: C7.2, C9.2, DMUX1.9 (VDD), DMUX2.9 (VDD), FFC_US1.4, FFC_US2.4, FFC_US3.4, FFC_US4.4, FFC_US5.4, FFC_US6.4, FFC_US7.4, FFC_US8.4, FFC_US9.4, FFC_US10.4, FFC_US11.4, FFC_US12.4, FFC_US13.4, FFC_US14.4, FFC_US15.4, FFC_US16.4, JP1.3 (B), JP2.3 (B), JP3.3 (B), JP4.3 (A), JP5.3 (B), JP6.3 (B), LVL2.2 (VCCA), LVL3.2 (VCCA), R1.1, R2.1, R3.1, R7.1, R8.1; also elsewhere on the board
+3V3: C8.1, C10.1, LVL2.19 (VCCB), LVL3.19 (VCCB); also elsewhere on the board
/CH201/DMUX1_INTA_1V8: DMUX1.20 (INTA), LVL2.1 (A1)
/CH201/DMUX1_NRST_1V8: DMUX1.18 (~RESET), LVL2.8 (A7)
/CH201/DMUX2_INTA_1V8: DMUX2.20 (INTA), LVL3.8 (A7)
/CH201/DMUX2_NRST_1V8: DMUX2.18 (~RESET), LVL3.9 (A8)
/CH201/I2C_1V8.SCL: FFC_US1.7, FFC_US2.7, FFC_US3.7, FFC_US4.7, FFC_US5.7, FFC_US6.7, FFC_US7.7, FFC_US8.7, FFC_US9.7, FFC_US10.7, FFC_US11.7, FFC_US12.7, FFC_US13.7, FFC_US14.7, FFC_US15.7, FFC_US16.7, LVL3.3 (A2), R2.2
/CH201/I2C_1V8.SDA: FFC_US1.5, FFC_US2.5, FFC_US3.5, FFC_US4.5, FFC_US5.5, FFC_US6.5, FFC_US7.5, FFC_US8.5, FFC_US9.5, FFC_US10.5, FFC_US11.5, FFC_US12.5, FFC_US13.5, FFC_US14.5, FFC_US15.5, FFC_US16.5, LVL3.1 (A1), R1.2
/CH201/SPI_1V8_1.MISO: DMUX1.14 (SO), LVL2.4 (A3)
/CH201/SPI_1V8_1.MOSI: DMUX1.13 (SI), LVL2.5 (A4)
/CH201/SPI_1V8_1.SCLK: DMUX1.12 (SCK), LVL2.6 (A5)
/CH201/SPI_1V8_1.SCS: DMUX1.11 (~CS), LVL2.7 (A6)
/CH201/SPI_1V8_2.MISO: DMUX2.14 (SO), LVL3.4 (A3)
/CH201/SPI_1V8_2.MOSI: DMUX2.13 (SI), LVL3.5 (A4)
/CH201/SPI_1V8_2.SCLK: DMUX2.12 (SCK), LVL3.6 (A5)
/CH201/SPI_1V8_2.SCS: DMUX2.11 (~CS), LVL3.7 (A6)
/CH201/US_INT1: DMUX1.21 (GPA0), FFC_US1.1
/CH201/US_INT2: DMUX1.23 (GPA2), FFC_US2.1
/CH201/US_INT3: DMUX1.25 (GPA4), FFC_US3.1
/CH201/US_INT4: DMUX1.27 (GPA6), FFC_US4.1
/CH201/US_INT5: DMUX1.2 (GPB1), FFC_US5.1
/CH201/US_INT6: DMUX1.3 (GPB2), FFC_US6.1
/CH201/US_INT7: DMUX1.5 (GPB4), FFC_US7.1
/CH201/US_INT8: DMUX1.7 (GPB6), FFC_US8.1
/CH201/US_INT9: DMUX2.21 (GPA0), FFC_US9.1
/CH201/US_INT10: DMUX2.23 (GPA2), FFC_US10.1
/CH201/US_INT11: DMUX2.25 (GPA4), FFC_US11.1
/CH201/US_INT12: DMUX2.27 (GPA6), FFC_US12.1
/CH201/US_INT13: DMUX2.2 (GPB1), FFC_US13.1
/CH201/US_INT14: DMUX2.3 (GPB2), FFC_US14.1
/CH201/US_INT15: DMUX2.5 (GPB4), FFC_US15.1
/CH201/US_INT16: DMUX2.7 (GPB6), FFC_US16.1
/CH201/US_NRST_1V8: FFC_US1.2, FFC_US2.2, FFC_US3.2, FFC_US4.2, FFC_US5.2, FFC_US6.2, FFC_US7.2, FFC_US8.2, FFC_US9.2, FFC_US10.2, FFC_US11.2, FFC_US12.2, FFC_US13.2, FFC_US14.2, FFC_US15.2, FFC_US16.2, LVL2.3 (A2), R3.2
/CH201/US_PROG1: DMUX1.22 (GPA1), FFC_US1.3
/CH201/US_PROG2: DMUX1.24 (GPA3), FFC_US2.3
/CH201/US_PROG3: DMUX1.26 (GPA5), FFC_US3.3
/CH201/US_PROG4: DMUX1.28 (GPA7), FFC_US4.3
/CH201/US_PROG5: DMUX1.1 (GPB0), FFC_US5.3
/CH201/US_PROG6: DMUX1.4 (GPB3), FFC_US6.3
/CH201/US_PROG7: DMUX1.6 (GPB5), FFC_US7.3
/CH201/US_PROG8: DMUX1.8 (GPB7), FFC_US8.3
/CH201/US_PROG9: DMUX2.22 (GPA1), FFC_US9.3
/CH201/US_PROG10: DMUX2.24 (GPA3), FFC_US10.3
/CH201/US_PROG11: DMUX2.26 (GPA5), FFC_US11.3
/CH201/US_PROG12: DMUX2.28 (GPA7), FFC_US12.3
/CH201/US_PROG13: DMUX2.1 (GPB0), FFC_US13.3
/CH201/US_PROG14: DMUX2.4 (GPB3), FFC_US14.3
/CH201/US_PROG15: DMUX2.6 (GPB5), FFC_US15.3
/CH201/US_PROG16: DMUX2.8 (GPB7), FFC_US16.3
/DMUX1_INTA: LVL2.20 (B1); also elsewhere on the board
/DMUX1_NRST: LVL2.13 (B7); also elsewhere on the board
/DMUX2_INTA: LVL3.13 (B7); also elsewhere on the board
/DMUX2_NRST: LVL3.12 (B8); also elsewhere on the board
/DMUX_SCS: LVL2.14 (B6), LVL3.14 (B6); also elsewhere on the board
/I2C0.SCL: LVL3.18 (B2); also elsewhere on the board
/I2C0.SDA: LVL3.20 (B1); also elsewhere on the board
/SPI0.MISO: LVL2.17 (B3), LVL3.17 (B3); also elsewhere on the board
/SPI0.MOSI: LVL2.16 (B4), LVL3.16 (B4); also elsewhere on the board
/SPI0.SCLK: LVL2.15 (B5), LVL3.15 (B5); also elsewhere on the board
/US_NRST: LVL2.18 (B2); also elsewhere on the board
GND: C7.1, C8.2, C9.1, C10.2, DMUX1.10 (VSS), DMUX2.10 (VSS), FFC_US1.6, FFC_US2.6, FFC_US3.6, FFC_US4.6, FFC_US5.6, FFC_US6.6, FFC_US7.6, FFC_US8.6, FFC_US9.6, FFC_US10.6, FFC_US11.6, FFC_US12.6, FFC_US13.6, FFC_US14.6, FFC_US15.6, FFC_US16.6, JP1.1 (A), JP2.1 (A), JP3.1 (A), JP4.1 (B), JP5.1 (A), JP6.1 (A), LVL2.11 (GND), LVL3.11 (GND); also elsewhere on the board
unnamed: DMUX1.15 (A0), JP1.2 (C)
unnamed: DMUX1.16 (A1), JP2.2 (C)
unnamed: DMUX1.17 (A2), JP3.2 (C)
unnamed: DMUX2.15 (A0), JP4.2 (C)
unnamed: DMUX2.16 (A1), JP5.2 (C)
unnamed: DMUX2.17 (A2), JP6.2 (C)
unnamed: LVL2.10 (OE), R7.2
unnamed: LVL3.10 (OE), R8.2

Notes on the sheet:
US Sensors
16 CH201s Uses shared I2C bus and reset pin. US_INTs and US_PROGs will be multiplexed by 2 digital multiplexers on the right.
Digital Multiplexers

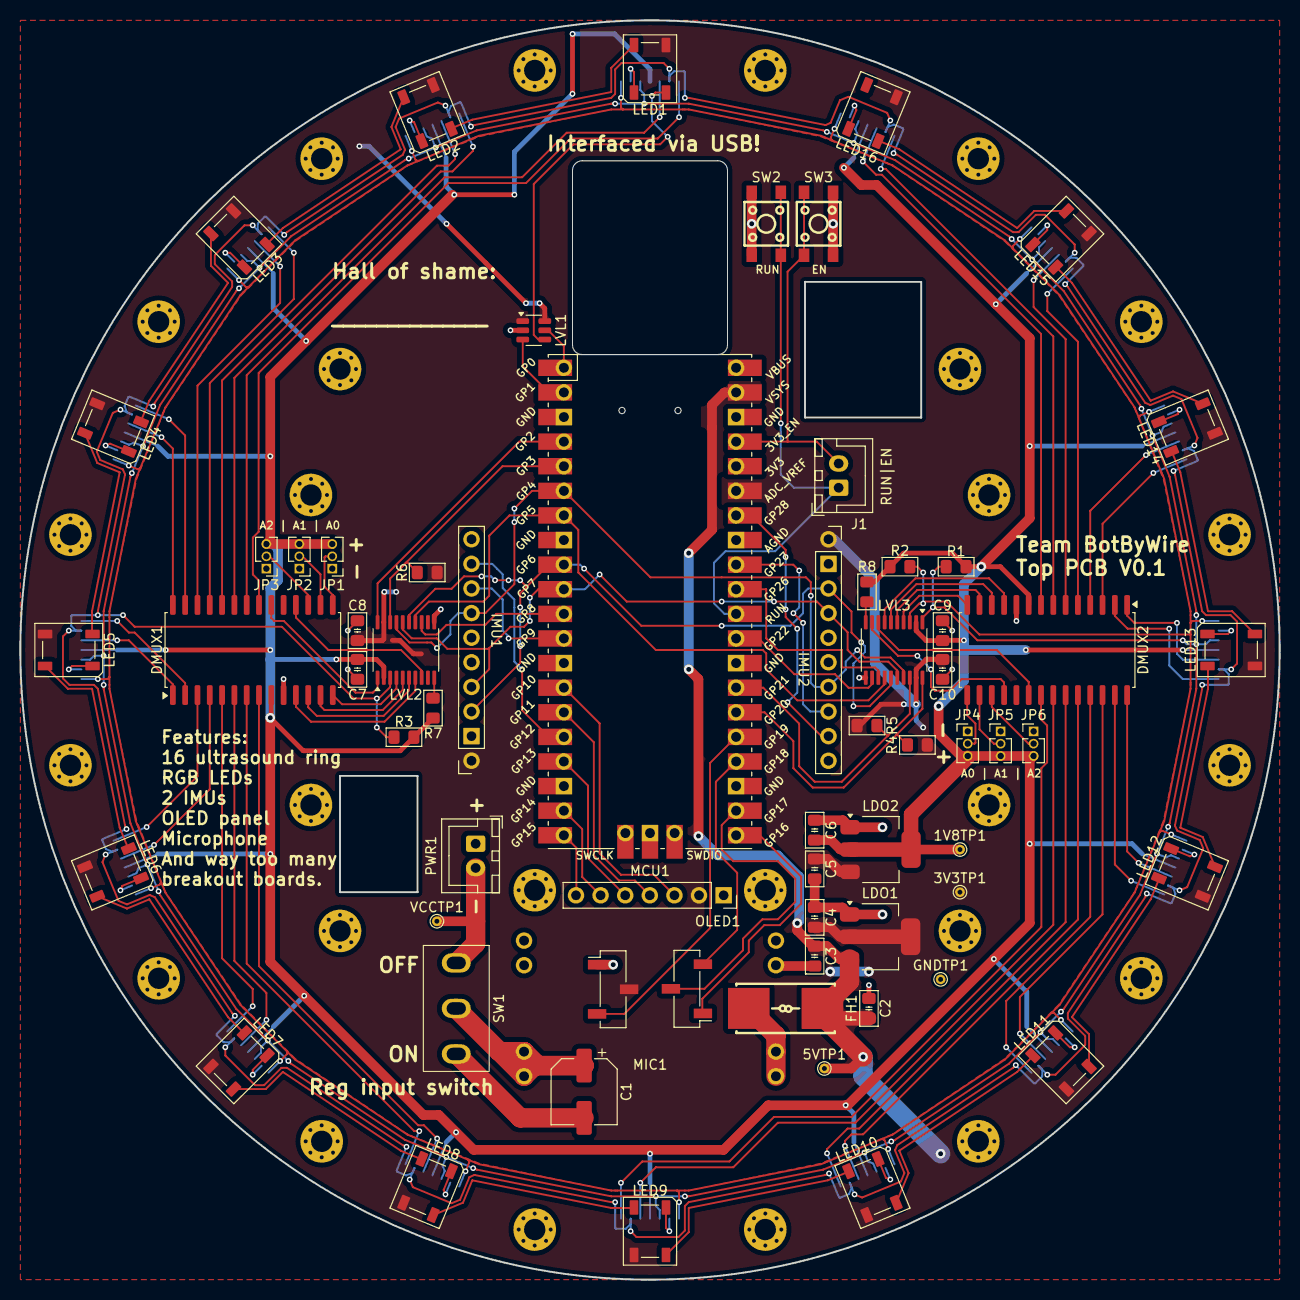
[picture p17: board hardware/top-plate/pcb/pcb.kicad_pcb from above]

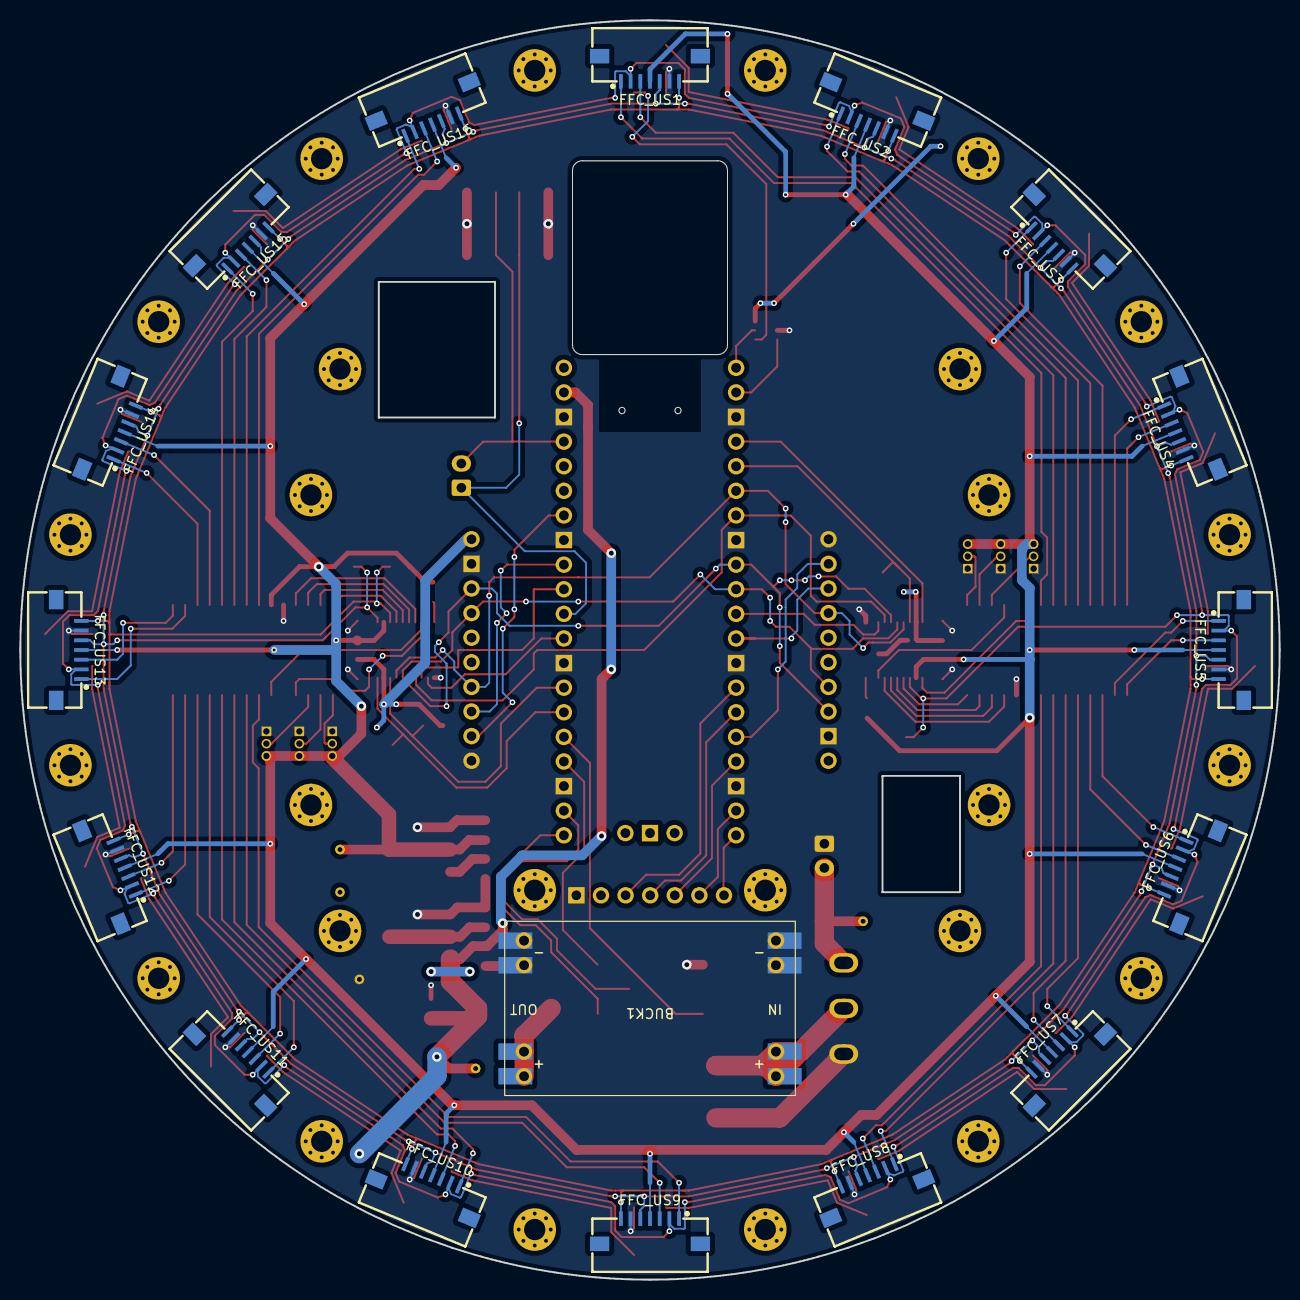
[picture p18: board hardware/top-plate/pcb/pcb.kicad_pcb from below]

Board: 2 copper layers, 130.0 x 130.0 mm, 104 parts (17 on the bottom side), 106 nets.
