Froggy111/RBC-soccer-2025/hardware/ultrasound/pcb/pcb.kicad_pcb

## KiCad design hardware/ultrasound/pcb/pcb.kicad_pcb (2025-01-09)

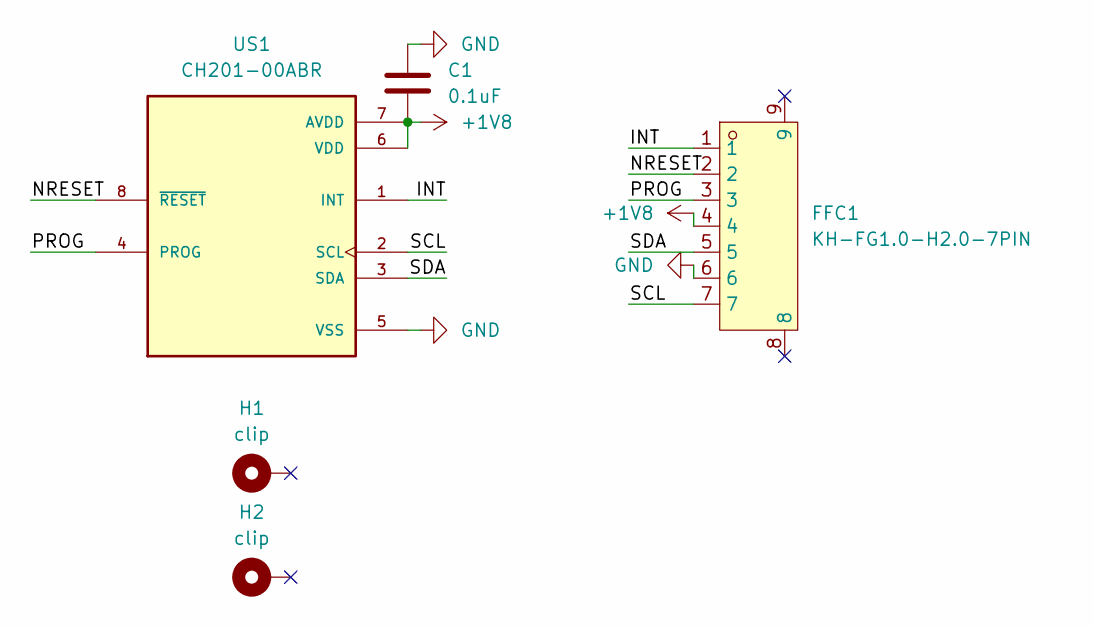
[picture p19: schematic pcb.kicad_sch]

Parts:
C1: 0.1uF; C_1206_3216Metric_Pad1.33x1.80mm_HandSolder
FFC1: KH-FG1.0-H2.0-7PIN; FPC-SMD_7P-P1.0_KINGHELM_KH-FG1.0-H2.0-7PIN; LCSC Part C2925379
H1, H2: clip
US1: CH201-00ABR; CH201-00ABR_XDCR_CH201-00ABR; PARTREV 1.1

Connections:
+1V8: C1.2, FFC1.4, US1.6 (VDD), US1.7 (AVDD)
/INT: FFC1.1, US1.1 (INT)
/NRESET: FFC1.2, US1.8 (~RESET)
/PROG: FFC1.3, US1.4 (PROG)
/SCL: FFC1.7, US1.2 (SCL)
/SDA: FFC1.5, US1.3 (SDA)
GND: C1.1, FFC1.6, US1.5 (VSS)

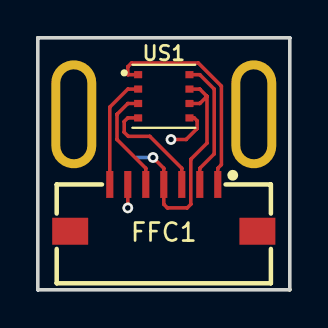
[picture p20: board hardware/ultrasound/pcb/pcb.kicad_pcb from above]

Board: 2 copper layers, 14.0 x 14.0 mm, 5 parts (1 on the bottom side), 7 nets.
