Froggy111/RBC-soccer-2025/hardware/middle-plate/pcb/pcb.kicad_pcb

## KiCad design hardware/middle-plate/pcb/pcb.kicad_pcb (2025-01-09)

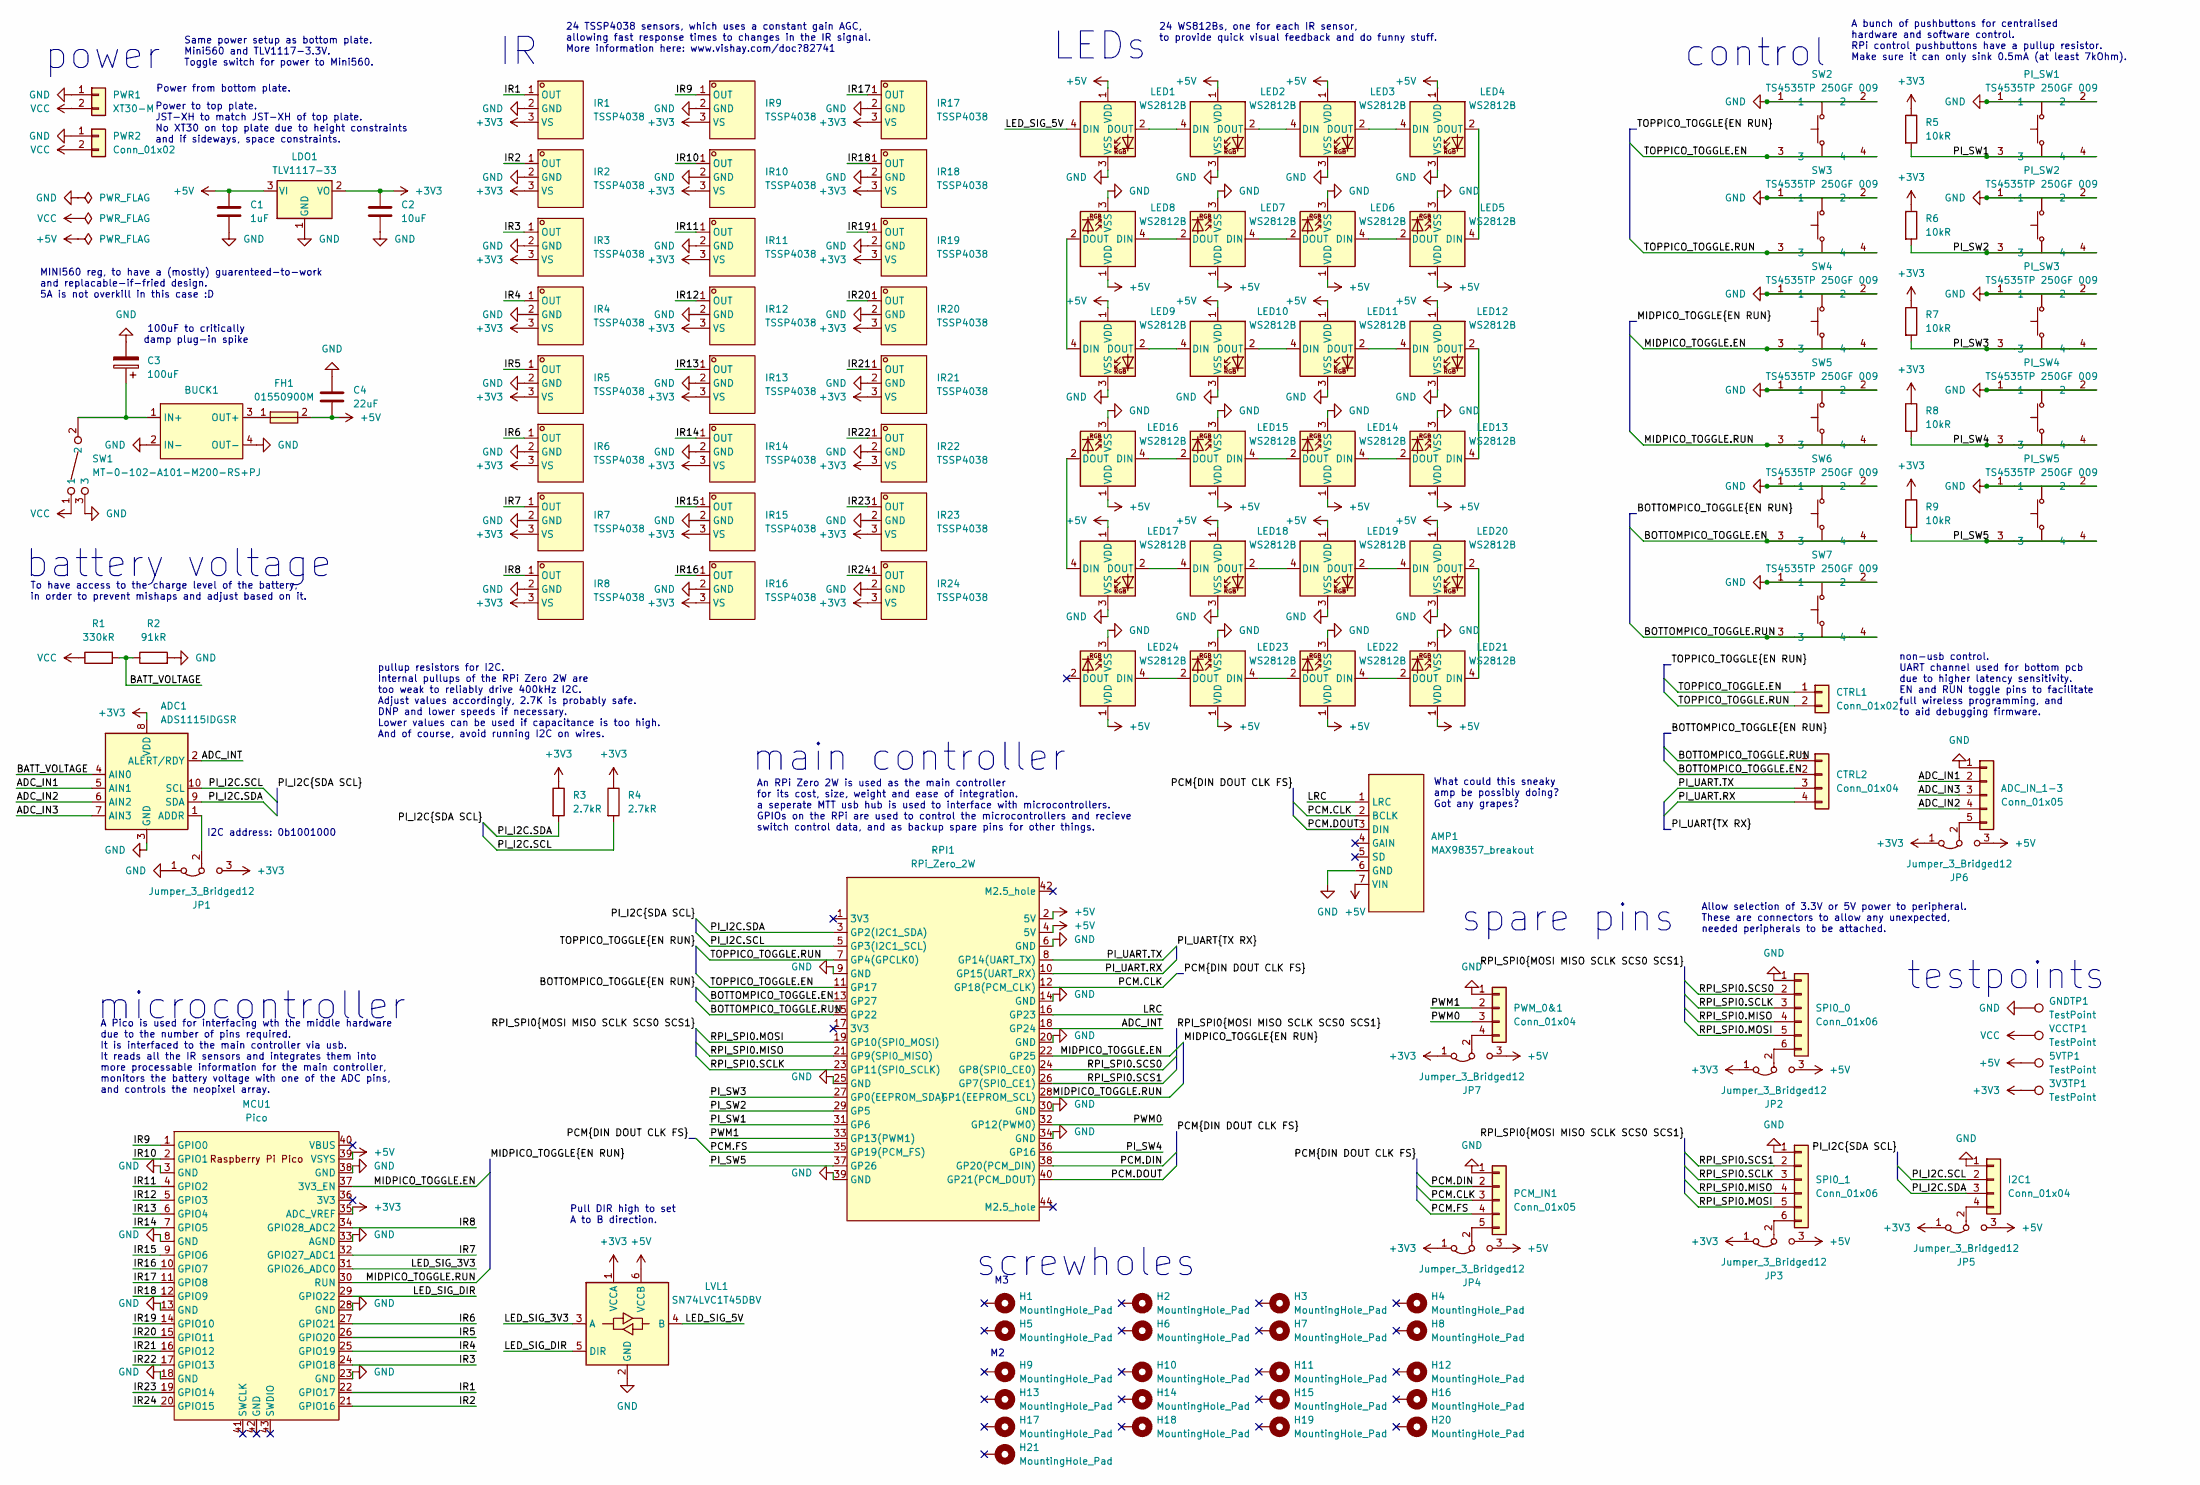
[picture p21: schematic pcb.kicad_sch]

Parts:
3V3TP1, 5VTP1: TestPoint; TestPoint_THTPad_D1.0mm_Drill0.5mm
ADC1: ADS1115IDGSR; TSSOP-10_3x3mm_P0.5mm
ADC_IN_1-3: Conn_01x05; JST_XH_B5B-XH-A_1x05_P2.50mm_Vertical
AMP1: MAX98357_breakout; MAX98357_breakout_no_mountingholes
BUCK1: mini560
C1: 1uF; C_0805_2012Metric_Pad1.15x1.40mm_HandSolder
C2: 10uF; C_0805_2012Metric_Pad1.15x1.40mm_HandSolder
C3: 100uF; CP_Elec_6.3x7.7
C4: 22uF; C_0805_2012Metric_Pad1.15x1.40mm_HandSolder
CTRL1: Conn_01x02; JST_XH_B2B-XH-A_1x02_P2.50mm_Vertical
CTRL2: Conn_01x04; JST_XH_B4B-XH-A_1x04_P2.50mm_Vertical
FH1: 01550900M; FUSE-SMD_L9.8-W5.0; LCSC Part C108518
GNDTP1: TestPoint; TestPoint_THTPad_D1.0mm_Drill0.5mm
H1, H2, H3, H4, H5, H6, H7, H8: MountingHole_Pad; MountingHole_3.2mm_M3_Pad_Via
H9, H10, H11, H12, H13, H14, H15, H16, H17, H18, H19, H20, H21: MountingHole_Pad; MountingHole_2.2mm_M2_Pad_Via
I2C1: Conn_01x04; JST_XH_B4B-XH-A_1x04_P2.50mm_Vertical
IR1, IR2, IR3, IR4, IR5, IR6, IR7, IR8, IR9, IR10, IR11, IR12, IR13, IR14, IR15, IR16, IR17, IR18, IR19, IR20, IR21, IR22, IR23, IR24: TSSP4038; SENSOR-TH_TSSP40X; LCSC Part C143753
JP1, JP2, JP3, JP4, JP5, JP6, JP7: Jumper_3_Bridged12; PinHeader_1x03_P1.27mm_Vertical
LDO1: TLV1117-33; SOT-223-3_TabPin2
LED1, LED2, LED3, LED4, LED5, LED6, LED7, LED8, LED9, LED10, LED11, LED12, LED13, LED14, LED15, LED16, LED17, LED18, LED19, LED20, LED21, LED22, LED23, LED24: WS2812B; LED_WS2812B-Mini_PLCC4_3.5x3.5mm
LVL1: SN74LVC1T45DBV; SOT-23-6
MCU1: Pico; RPi_Pico_SMD_TH_USBC_cable_cutout
PCM_IN1: Conn_01x05; JST_XH_B5B-XH-A_1x05_P2.50mm_Vertical
PI_SW1, PI_SW2, PI_SW3, PI_SW4, PI_SW5: TS4535TP 250GF 009; SW-SMD_4P-L4.5-W4.5-P3.00-LS6.8; LCSC Part C5342982
PWM_0&1: Conn_01x04; JST_XH_B4B-XH-A_1x04_P2.50mm_Vertical
PWR1: XT30-M; AMASS_XT30U-M_1x02_P5.0mm_Vertical
PWR2: Conn_01x02; JST_XH_B2B-XH-A_1x02_P2.50mm_Vertical
R1: 330kR; R_1206_3216Metric_Pad1.30x1.75mm_HandSolder
R2: 91kR; R_1206_3216Metric_Pad1.30x1.75mm_HandSolder
R3, R4: 2.7kR; R_1206_3216Metric_Pad1.30x1.75mm_HandSolder
R5, R6, R7, R8, R9: 10kR; R_1206_3216Metric_Pad1.30x1.75mm_HandSolder
RPI1: RPi_Zero_2W; RPi_Zero_2W_no_front_mountingholes
SPI0_0, SPI0_1: Conn_01x06; JST_XH_B6B-XH-A_1x06_P2.50mm_Vertical
SW1: MT-0-102-A101-M200-RS+PJ; SW-TH_MT-0-103-A101-M200-RS; LCSC Part C1788492
SW2, SW3, SW4, SW5, SW6, SW7: TS4535TP 250GF 009; SW-SMD_4P-L4.5-W4.5-P3.00-LS6.8; LCSC Part C5342982
VCCTP1: TestPoint; TestPoint_THTPad_D1.0mm_Drill0.5mm

Connections:
+3V3: 3V3TP1.1, ADC1.8 (VDD), C2.2, IR1.3 (VS), IR2.3 (VS), IR3.3 (VS), IR4.3 (VS), IR5.3 (VS), IR6.3 (VS), IR7.3 (VS), IR8.3 (VS), IR9.3 (VS), IR10.3 (VS), IR11.3 (VS), IR12.3 (VS), IR13.3 (VS), IR14.3 (VS), IR15.3 (VS), IR16.3 (VS), IR17.3 (VS), IR18.3 (VS), IR19.3 (VS), IR20.3 (VS), IR21.3 (VS), IR22.3 (VS), IR23.3 (VS), IR24.3 (VS), JP1.3 (B), JP2.1 (A), JP3.1 (A), JP4.1 (A), JP5.1 (A), JP6.1 (A), JP7.1 (A), LDO1.2 (VO), LVL1.1 (VCCA), MCU1.35 (ADC_VREF), R3.1, R4.1, R5.1, R6.1, R7.1, R8.1, R9.1
+5V: 5VTP1.1, AMP1.7 (VIN), C1.2, C4.2, FH1.2, JP2.3 (B), JP3.3 (B), JP4.3 (B), JP5.3 (B), JP6.3 (B), JP7.3 (B), LDO1.3 (VI), LED1.1 (VDD), LED2.1 (VDD), LED3.1 (VDD), LED4.1 (VDD), LED5.1 (VDD), LED6.1 (VDD), LED7.1 (VDD), LED8.1 (VDD), LED9.1 (VDD), LED10.1 (VDD), LED11.1 (VDD), LED12.1 (VDD), LED13.1 (VDD), LED14.1 (VDD), LED15.1 (VDD), LED16.1 (VDD), LED17.1 (VDD), LED18.1 (VDD), LED19.1 (VDD), LED20.1 (VDD), LED21.1 (VDD), LED22.1 (VDD), LED23.1 (VDD), LED24.1 (VDD), LVL1.6 (VCCB), MCU1.39 (VSYS), RPI1.2 (5V), RPI1.4 (5V)
/ADC_IN1: ADC1.5 (AIN1), ADC_IN_1-3.2
/ADC_IN2: ADC1.6 (AIN2), ADC_IN_1-3.4
/ADC_IN3: ADC1.7 (AIN3), ADC_IN_1-3.3
/ADC_INT: ADC1.2 (ALERT/RDY), RPI1.18 (GP24)
/BATT_VOLTAGE: ADC1.4 (AIN0), R1.2, R2.1
/BOTTOMPICO_TOGGLE.EN: CTRL2.2, RPI1.13 (GP27), SW6.3, SW6.4
/BOTTOMPICO_TOGGLE.RUN: CTRL2.1, RPI1.15 (GP22), SW7.3, SW7.4
/IR1: IR1.1 (OUT), MCU1.22 (GPIO17)
/IR2: IR2.1 (OUT), MCU1.21 (GPIO16)
/IR3: IR3.1 (OUT), MCU1.24 (GPIO18)
/IR4: IR4.1 (OUT), MCU1.25 (GPIO19)
/IR5: IR5.1 (OUT), MCU1.26 (GPIO20)
/IR6: IR6.1 (OUT), MCU1.27 (GPIO21)
/IR7: IR7.1 (OUT), MCU1.32 (GPIO27_ADC1)
/IR8: IR8.1 (OUT), MCU1.34 (GPIO28_ADC2)
/IR9: IR9.1 (OUT), MCU1.1 (GPIO0)
/IR10: IR10.1 (OUT), MCU1.2 (GPIO1)
/IR11: IR11.1 (OUT), MCU1.4 (GPIO2)
/IR12: IR12.1 (OUT), MCU1.5 (GPIO3)
/IR13: IR13.1 (OUT), MCU1.6 (GPIO4)
/IR14: IR14.1 (OUT), MCU1.7 (GPIO5)
/IR15: IR15.1 (OUT), MCU1.9 (GPIO6)
/IR16: IR16.1 (OUT), MCU1.10 (GPIO7)
/IR17: IR17.1 (OUT), MCU1.11 (GPIO8)
/IR18: IR18.1 (OUT), MCU1.12 (GPIO9)
/IR19: IR19.1 (OUT), MCU1.14 (GPIO10)
/IR20: IR20.1 (OUT), MCU1.15 (GPIO11)
/IR21: IR21.1 (OUT), MCU1.16 (GPIO12)
/IR22: IR22.1 (OUT), MCU1.17 (GPIO13)
/IR23: IR23.1 (OUT), MCU1.19 (GPIO14)
/IR24: IR24.1 (OUT), MCU1.20 (GPIO15)
/LED_SIG_3V3: LVL1.3 (A), MCU1.31 (GPIO26_ADC0)
/LED_SIG_5V: LED1.4 (DIN), LVL1.4 (B)
/LED_SIG_DIR: LVL1.5 (DIR), MCU1.29 (GPIO22)
/LRC: AMP1.1 (LRC), RPI1.16 (GP23)
/MIDPICO_TOGGLE.EN: MCU1.37 (3V3_EN), RPI1.22 (GP25), SW4.3, SW4.4
/MIDPICO_TOGGLE.RUN: MCU1.30 (RUN), RPI1.28 (GP1(EEPROM_SCL)), SW5.3, SW5.4
/PCM.CLK: AMP1.2 (BCLK), PCM_IN1.3, RPI1.12 (GP18(PCM_CLK))
/PCM.DIN: PCM_IN1.2, RPI1.38 (GP20(PCM_DIN))
/PCM.DOUT: AMP1.3 (DIN), RPI1.40 (GP21(PCM_DOUT))
/PCM.FS: PCM_IN1.4, RPI1.35 (GP19(PCM_FS))
/PI_I2C.SCL: ADC1.10 (SCL), I2C1.2, R4.2, RPI1.5 (GP3(I2C1_SCL))
/PI_I2C.SDA: ADC1.9 (SDA), I2C1.3, R3.2, RPI1.3 (GP2(I2C1_SDA))
/PI_SW1: PI_SW1.3, PI_SW1.4, R5.2, RPI1.31 (GP6)
/PI_SW2: PI_SW2.3, PI_SW2.4, R6.2, RPI1.29 (GP5)
/PI_SW3: PI_SW3.3, PI_SW3.4, R7.2, RPI1.27 (GP0(EEPROM_SDA))
/PI_SW4: PI_SW4.3, PI_SW4.4, R8.2, RPI1.36 (GP16)
/PI_SW5: PI_SW5.3, PI_SW5.4, R9.2, RPI1.37 (GP26)
/PI_UART.RX: CTRL2.4, RPI1.10 (GP15(UART_RX))
/PI_UART.TX: CTRL2.3, RPI1.8 (GP14(UART_TX))
/PWM0: PWM_0&1.3, RPI1.32 (GP12(PWM0))
/PWM1: PWM_0&1.2, RPI1.33 (GP13(PWM1))
/RPI_SPI0.MISO: RPI1.21 (GP9(SPI0_MISO)), SPI0_0.4, SPI0_1.4
/RPI_SPI0.MOSI: RPI1.19 (GP10(SPI0_MOSI)), SPI0_0.5, SPI0_1.5
/RPI_SPI0.SCLK: RPI1.23 (GP11(SPI0_SCLK)), SPI0_0.3, SPI0_1.3
/RPI_SPI0.SCS0: RPI1.24 (GP8(SPI0_CE0)), SPI0_0.2
/RPI_SPI0.SCS1: RPI1.26 (GP7(SPI0_CE1)), SPI0_1.2
/TOPPICO_TOGGLE.EN: CTRL1.1, RPI1.11 (GP17), SW2.3, SW2.4
/TOPPICO_TOGGLE.RUN: CTRL1.2, RPI1.7 (GP4(GPCLK0)), SW3.3, SW3.4
GND: ADC1.3 (GND), ADC_IN_1-3.1, AMP1.6 (GND), BUCK1.2 (IN-), BUCK1.4 (OUT-), C1.1, C2.1, C3.2, C4.1, GNDTP1.1, I2C1.1, IR1.2 (GND), IR2.2 (GND), IR3.2 (GND), IR4.2 (GND), IR5.2 (GND), IR6.2 (GND), IR7.2 (GND), IR8.2 (GND), IR9.2 (GND), IR10.2 (GND), IR11.2 (GND), IR12.2 (GND), IR13.2 (GND), IR14.2 (GND), IR15.2 (GND), IR16.2 (GND), IR17.2 (GND), IR18.2 (GND), IR19.2 (GND), IR20.2 (GND), IR21.2 (GND), IR22.2 (GND), IR23.2 (GND), IR24.2 (GND), JP1.1 (A), LDO1.1 (GND), LED1.3 (VSS), LED2.3 (VSS), LED3.3 (VSS), LED4.3 (VSS), LED5.3 (VSS), LED6.3 (VSS), LED7.3 (VSS), LED8.3 (VSS), LED9.3 (VSS), LED10.3 (VSS), LED11.3 (VSS), LED12.3 (VSS), LED13.3 (VSS), LED14.3 (VSS), LED15.3 (VSS), LED16.3 (VSS), LED17.3 (VSS), LED18.3 (VSS), LED19.3 (VSS), LED20.3 (VSS), LED21.3 (VSS), LED22.3 (VSS), LED23.3 (VSS), LED24.3 (VSS), LVL1.2 (GND), MCU1.3 (GND), MCU1.8 (GND), MCU1.13 (GND), MCU1.18 (GND), MCU1.23 (GND), MCU1.28 (GND), MCU1.33 (AGND), MCU1.38 (GND), PCM_IN1.1, PI_SW1.1, PI_SW1.2, PI_SW2.1, PI_SW2.2, PI_SW3.1, PI_SW3.2, PI_SW4.1, PI_SW4.2, PI_SW5.1, PI_SW5.2, PWM_0&1.1, PWR1.1, PWR2.1, R2.2, RPI1.6 (GND), RPI1.9 (GND), RPI1.14 (GND), RPI1.20 (GND), RPI1.25 (GND), RPI1.30 (GND), RPI1.34 (GND), RPI1.39 (GND), SPI0_0.1, SPI0_1.1, SW1.3, SW2.1, SW2.2, SW3.1, SW3.2, SW4.1, SW4.2, SW5.1, SW5.2, SW6.1, SW6.2, SW7.1, SW7.2
unnamed: ADC1.1 (ADDR), JP1.2 (C)
unnamed: ADC_IN_1-3.5, JP6.2 (C)
unnamed: BUCK1.1 (IN+), C3.1, SW1.2
unnamed: BUCK1.3 (OUT+), FH1.1
unnamed: I2C1.4, JP5.2 (C)
unnamed: JP2.2 (C), SPI0_0.6
unnamed: JP3.2 (C), SPI0_1.6
unnamed: JP4.2 (C), PCM_IN1.5
unnamed: JP7.2 (C), PWM_0&1.4
unnamed: LED1.2 (DOUT), LED2.4 (DIN)
unnamed: LED2.2 (DOUT), LED3.4 (DIN)
unnamed: LED3.2 (DOUT), LED4.4 (DIN)
unnamed: LED4.2 (DOUT), LED5.4 (DIN)
unnamed: LED5.2 (DOUT), LED6.4 (DIN)
unnamed: LED6.2 (DOUT), LED7.4 (DIN)
unnamed: LED7.2 (DOUT), LED8.4 (DIN)
unnamed: LED8.2 (DOUT), LED9.4 (DIN)
unnamed: LED9.2 (DOUT), LED10.4 (DIN)
unnamed: LED10.2 (DOUT), LED11.4 (DIN)
unnamed: LED11.2 (DOUT), LED12.4 (DIN)
unnamed: LED12.2 (DOUT), LED13.4 (DIN)
unnamed: LED13.2 (DOUT), LED14.4 (DIN)
unnamed: LED14.2 (DOUT), LED15.4 (DIN)
unnamed: LED15.2 (DOUT), LED16.4 (DIN)
unnamed: LED16.2 (DOUT), LED17.4 (DIN)
unnamed: LED17.2 (DOUT), LED18.4 (DIN)
unnamed: LED18.2 (DOUT), LED19.4 (DIN)
unnamed: LED19.2 (DOUT), LED20.4 (DIN)
unnamed: LED20.2 (DOUT), LED21.4 (DIN)
unnamed: LED21.2 (DOUT), LED22.4 (DIN)
unnamed: LED22.2 (DOUT), LED23.4 (DIN)
unnamed: LED23.2 (DOUT), LED24.4 (DIN)
VCC: PWR1.2, PWR2.2, R1.1, SW1.1, VCCTP1.1

Notes on the sheet:
screwholes
Allow selection of 3.3V or 5V power to peripheral. These are connectors to allow any unexpected, needed peripherals to be attached.
microcontroller
24 WS812Bs, one for each IR sensor, to provide quick visual feedback and do funny stuff.
main controller
24 TSSP4038 sensors, which uses a constant gain AGC, allowing fast response times to changes in the IR signal. More information here: www.vishay.com/doc?82741
power
What could this sneaky amp be possibly doing? Got any grapes?
MINI560 reg, to have a (mostly) guarenteed-to-work and replacable-if-fried design. 5A is not overkill in this case :D
control
I2C address: 0b1001000
LEDs
pullup resistors for I2C. Internal pullups of the RPi Zero 2W are too weak to reliably drive 400kHz I2C. Adjust values accordingly, 2.7K is probably safe. DNP and lower speeds if necessary. Lower values can be used if capacitance is too high. And of course, avoid running I2C on wires.
Power from bottom plate.
spare pins
A bunch of pushbuttons for centralised hardware and software control. RPi control pushbuttons have a pullup resistor. Make sure it can only sink 0.5mA (at least 7kOhm).
A Pico is used for interfacing wth the middle hardware due to the number of pins required. It is interfaced to the main controller via usb. It reads all the IR sensors and integrates them into more processable information for the main controller, monitors the battery voltage with one of the ADC pin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
An RPi Zero 2W is used as the main controller for its cost, size, weight and ease of integration. a seperate MTT usb hub is used to interface with microcontrollers. GPIOs on the RPi are used to control the microcontrollers and recieve switch control data, and as backup spare pins for other things.
To have access to the charge level of the battery, in order to prevent mishaps and adjust based on it.
testpoints
Power to top plate. JST-XH to match JST-XH of top plate. No XT30 on top plate due to height constraints and if sideways, space constraints.
Pull DIR high to set A to B direction.
100uF to critically damp plug-in spike
battery voltage
Same power setup as bottom plate. Mini560 and TLV1117-3.3V. Toggle switch for power to Mini560.
non-usb control. UART channel used for bottom pcb due to higher latency sensitivity. EN and RUN toggle pins to facilitate full wireless programming, and to aid debugging firmware.

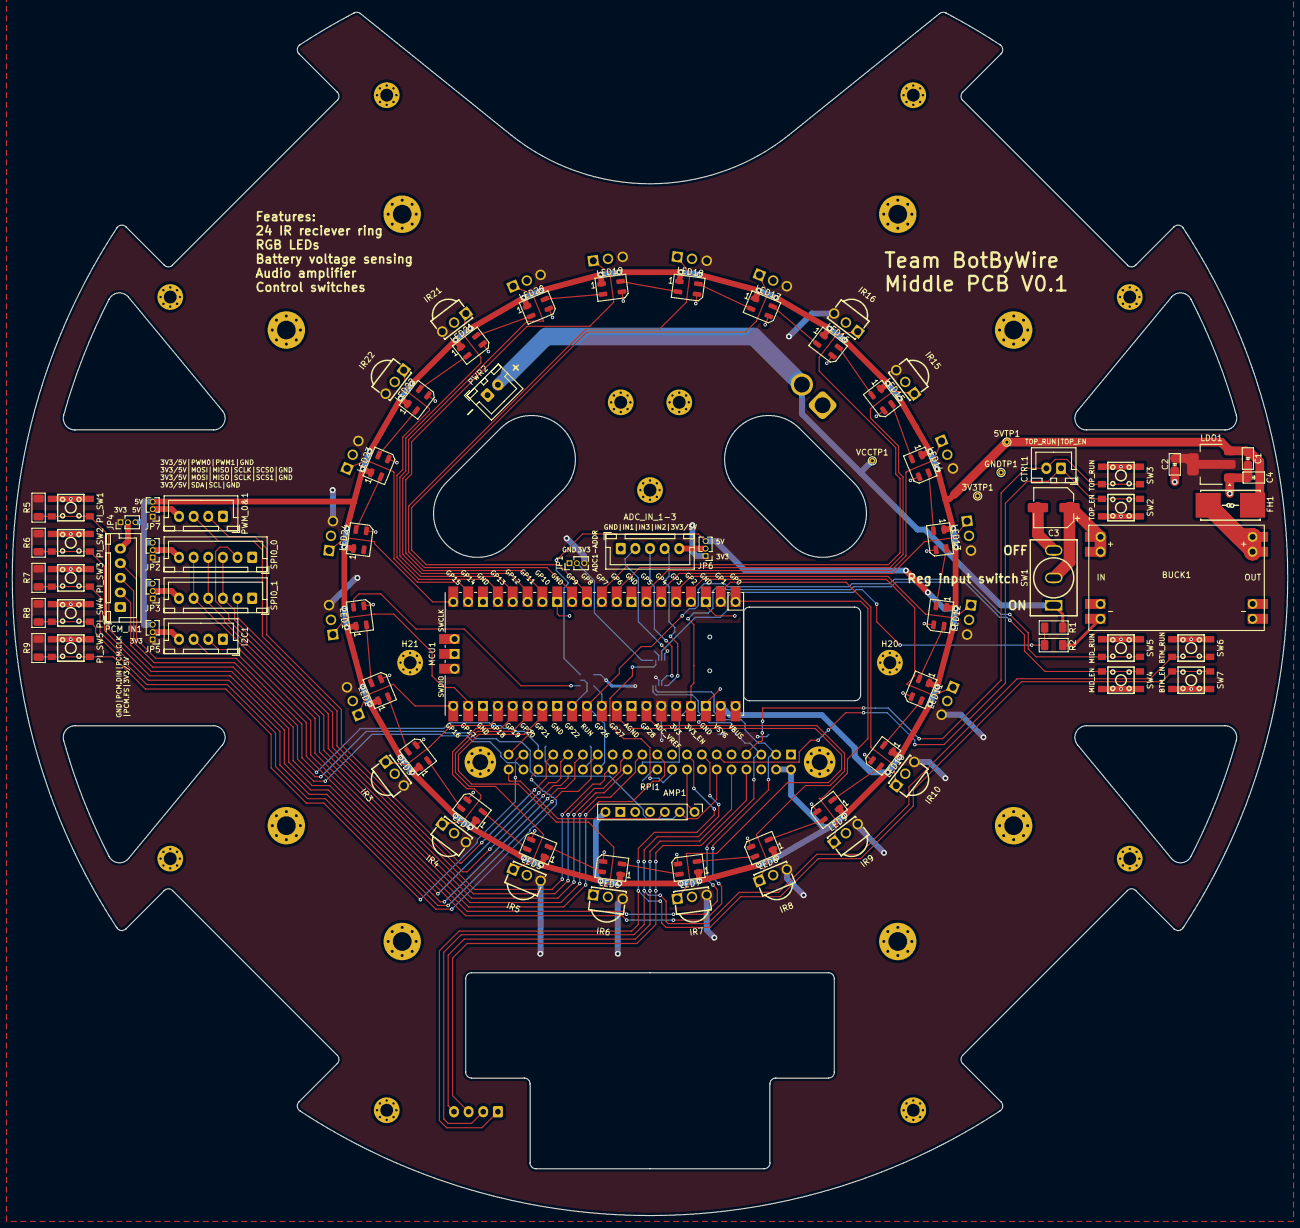
[picture p22: board hardware/middle-plate/pcb/pcb.kicad_pcb from above]

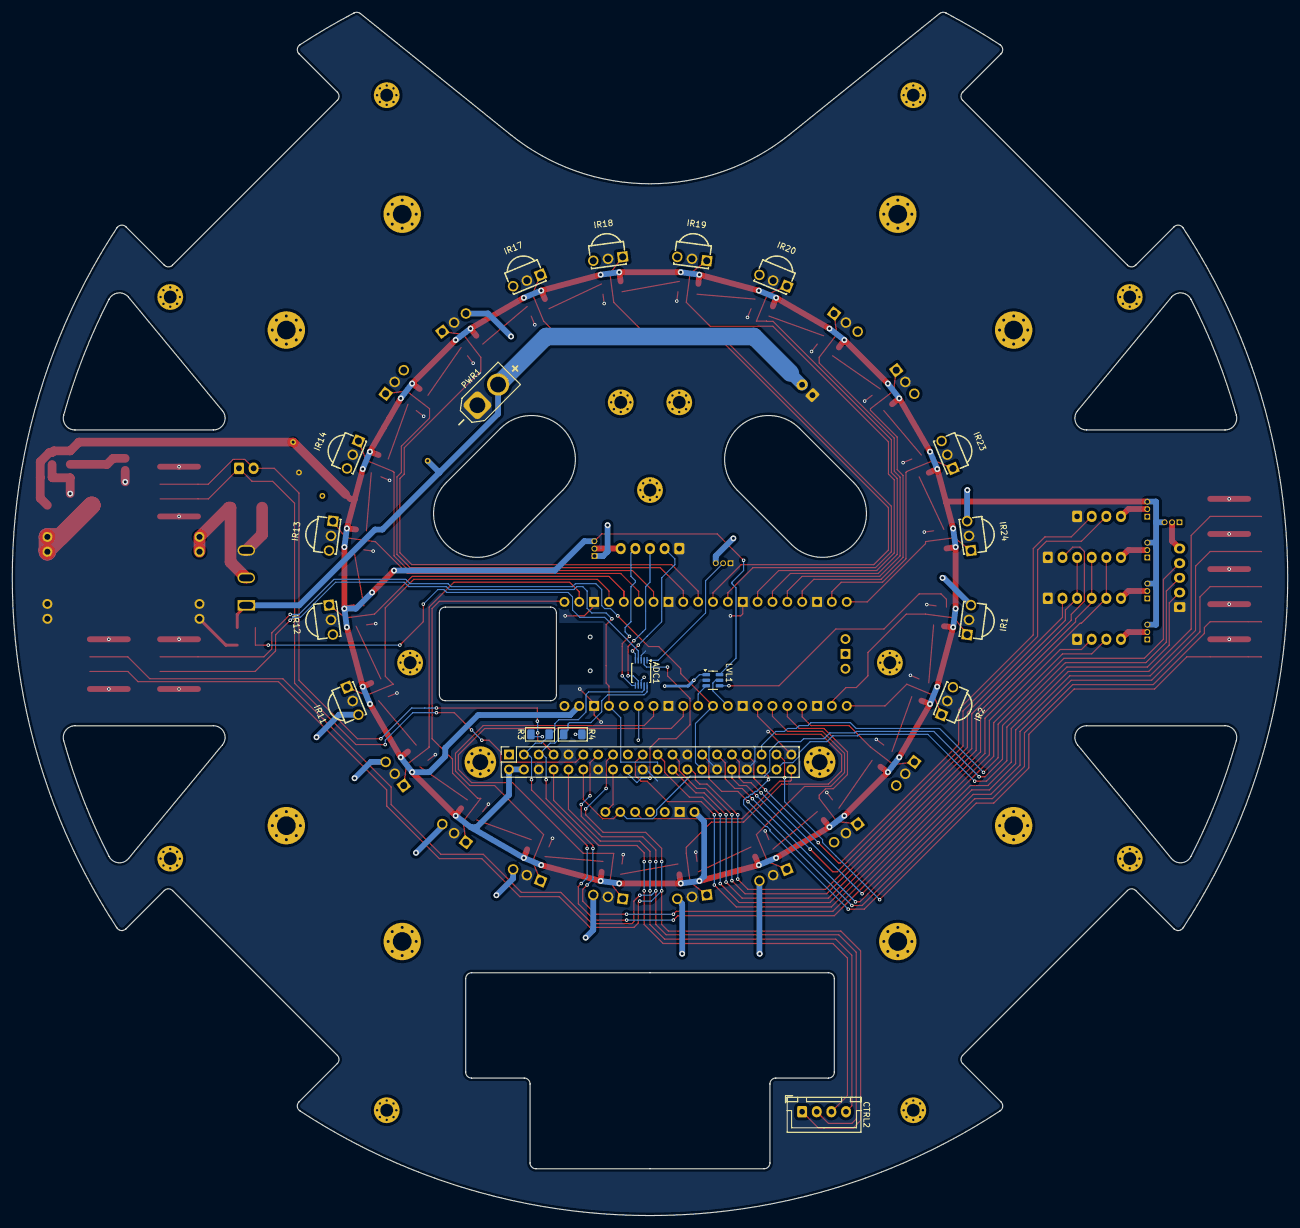
[picture p23: board hardware/middle-plate/pcb/pcb.kicad_pcb from below]

Board: 2 copper layers, 218.0 x 205.7 mm, 123 parts (18 on the bottom side), 95 nets.
