Froggy111/RBC-soccer-2025/hardware/bottom-plate/pcb/pcb.kicad_pcb

## KiCad design hardware/bottom-plate/pcb/pcb.kicad_pcb (2024-12-23)

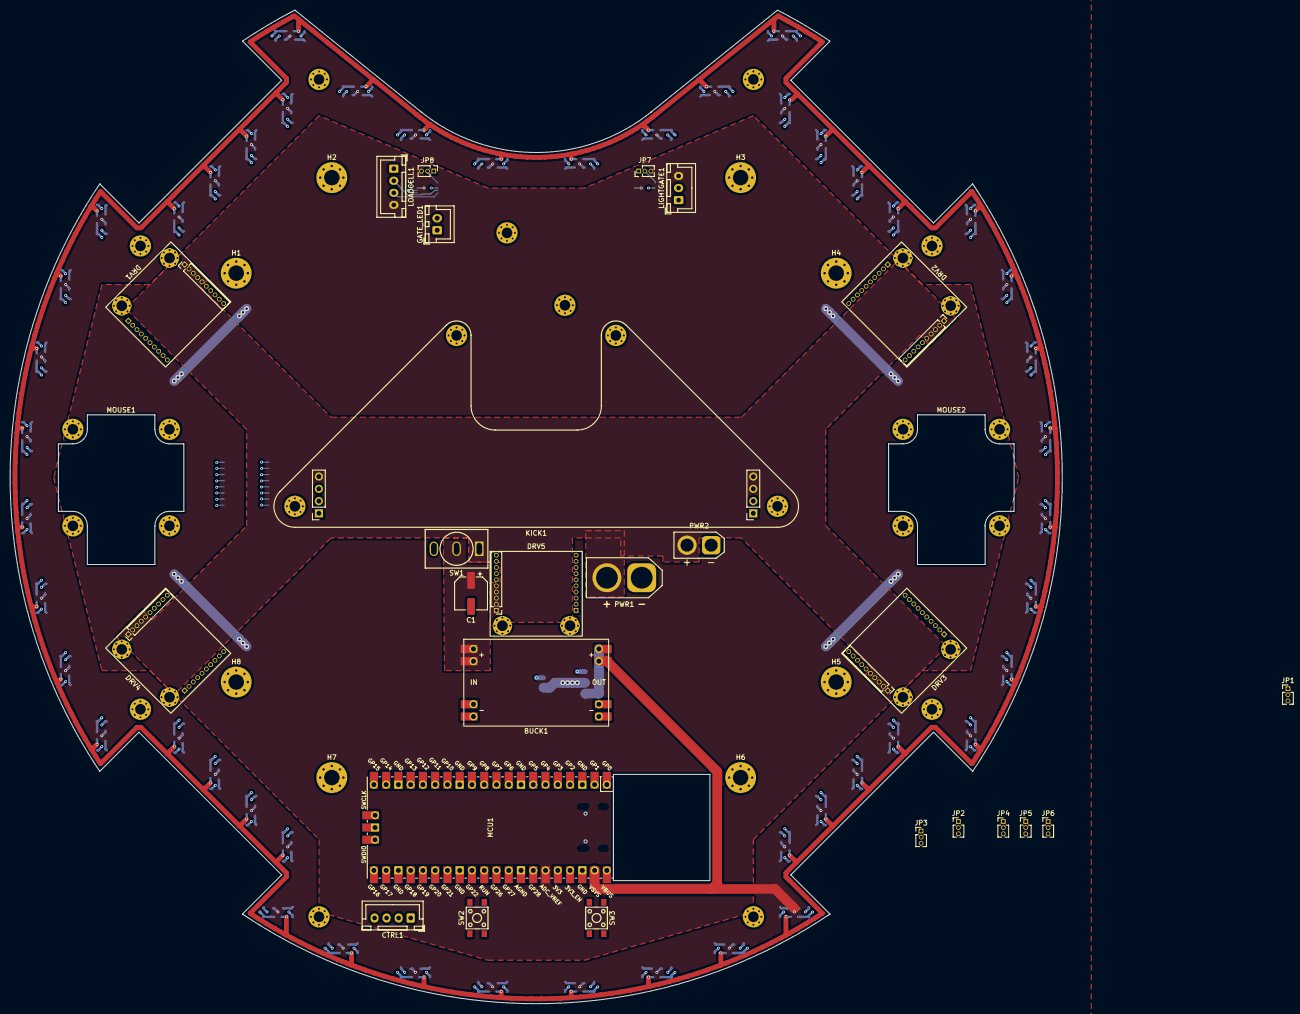
[picture p24: board hardware/bottom-plate/pcb/pcb.kicad_pcb from above]

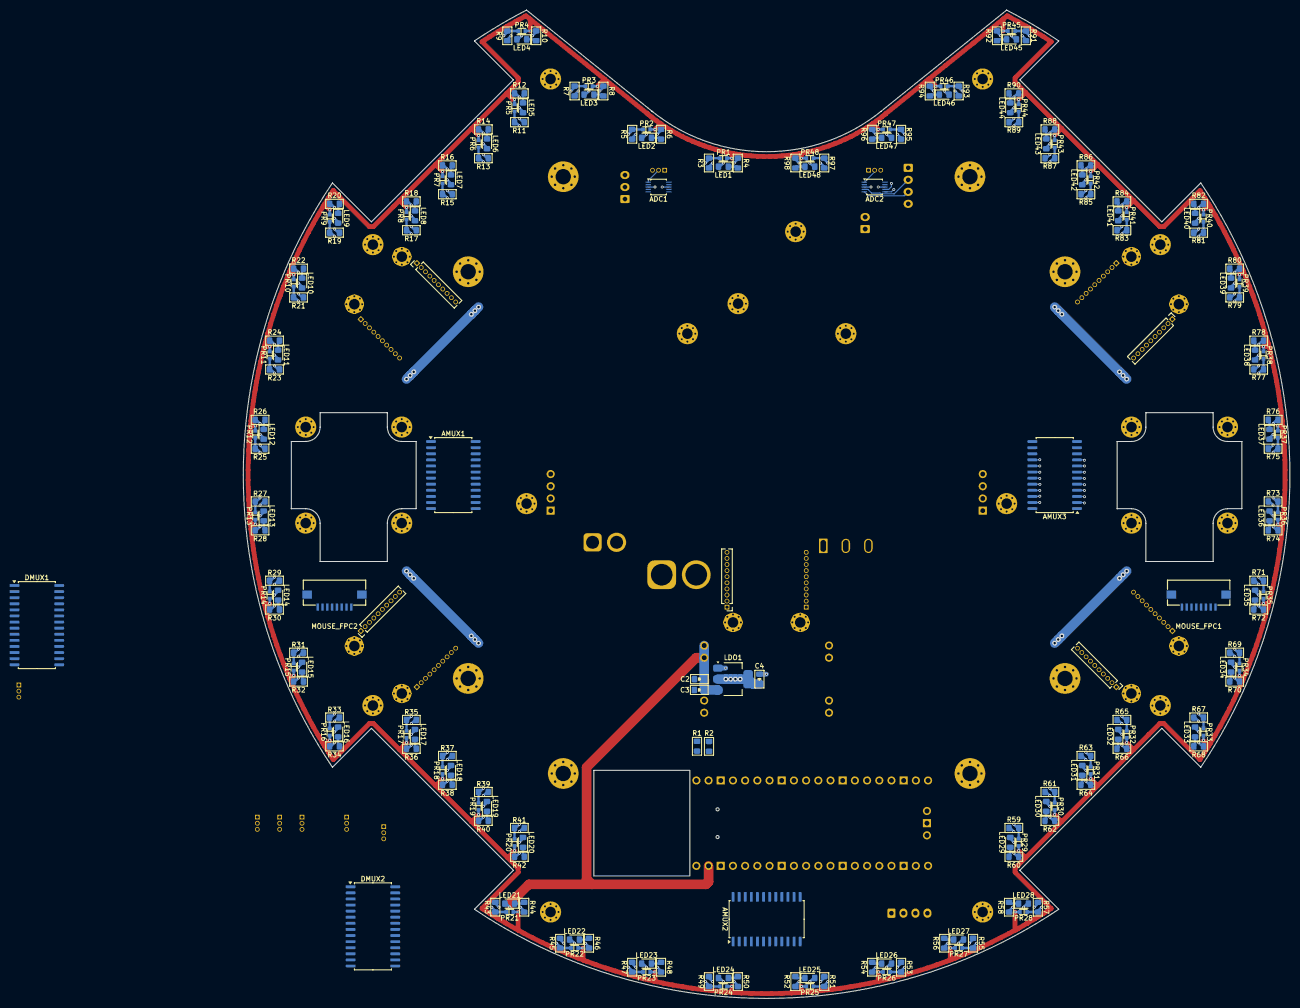
[picture p25: board hardware/bottom-plate/pcb/pcb.kicad_pcb from below]

Board: 4 copper layers, 218.0 x 205.9 mm, 253 parts (207 on the bottom side), 177 nets.

Parts:
ADC1, ADC2: ADS1115IDGSR; TSSOP-10_3x3mm_P0.5mm
AMUX1, AMUX2, AMUX3: CD74HC4067M; SOIC-24W_7.5x15.4mm_P1.27mm
BUCK1: mini560
C1: 150uF; CP_Elec_6.3x7.7
C2: 22uF; C_0805_2012Metric_Pad1.15x1.40mm_HandSolder
C3: 1uF; C_0805_2012Metric_Pad1.15x1.40mm_HandSolder
C4: 10uF; C_0805_2012Metric_Pad1.15x1.40mm_HandSolder
CTRL1: Conn_01x04; JST_XH_B4B-XH-A_1x04_P2.50mm_Vertical
DMUX1, DMUX2: MCP23S17_SO; SOIC-28W_7.5x17.9mm_P1.27mm
DRV1, DRV2, DRV3, DRV4, DRV5: DRV8224_breakout
GATE_LED1: Conn_01x02; JST_XH_B2B-XH-A_1x02_P2.50mm_Vertical
H1, H2, H3, H4, H5, H6, H7, H8: MountingHole_Pad; MountingHole_3.2mm_M3_Pad_Via
H9, H10, H11, H12, H13, H14, H15, H16, H17, H18: MountingHole_Pad; MountingHole_2.2mm_M2_Pad_Via
JP1, JP2, JP3, JP5, JP6, JP7: Jumper_3_Bridged12; PinHeader_1x03_P1.27mm_Vertical
JP4, JP8: Jumper_3_Bridged23; PinHeader_1x03_P1.27mm_Vertical
KICK1: kicker
LDO1: TLV1117-33; SOT-223-3_TabPin2
LED1, LED2, LED3, LED4, LED5, LED6, LED7, LED8, LED9, LED10, LED11, LED12, LED13, LED14, LED15, LED16, LED17, LED18, LED19, LED20, LED21, LED22, LED23, LED24, LED25, LED26, LED27, LED28, LED29, LED30, LED31, LED32, LED33, LED34, LED35, LED36, LED37, LED38, LED39, LED40, LED41, LED42, LED43, LED44, LED45, LED46, LED47, LED48: 2.8-3.4V 1400mcd@20mA; D_0805_2012Metric_Pad1.15x1.40mm_HandSolder
LIGHTGATE1: Conn_01x03; JST_XH_B3B-XH-A_1x03_P2.50mm_Vertical
LOADCELL1: Conn_01x04; JST_XH_B4B-XH-A_1x04_P2.50mm_Vertical
MCU1: Pico; RPi_Pico_SMD_TH_USBC_cable_cutout
MOUSE1, MOUSE2: PMW3360_breakout
MOUSE_FPC1, MOUSE_FPC2: FC10-S08FCT-00; FPC-SMD_8P-P1.00_DEALON_FC10-S08FCT-00
PR1, PR2, PR3, PR4, PR5, PR6, PR7, PR8, PR9, PR10, PR11, PR12, PR13, PR14, PR15, PR16, PR17, PR18, PR19, PR20, PR21, PR22, PR23, PR24, PR25, PR26, PR27, PR28, PR29, PR30, PR31, PR32, PR33, PR34, PR35, PR36, PR37, PR38, PR39, PR40, PR41, PR42, PR43, PR44, PR45, PR46, PR47, PR48: ALS-PT19; SENSORS-SMD_ALS-PT19
PWR1: XT60-M; AMASS_XT60-M_1x02_P7.20mm_Vertical
PWR2: XT30-F; AMASS_XT30U-F_1x02_P5.0mm_Vertical
R1, R2: 2.7K; R_0805_2012Metric_Pad1.15x1.40mm_HandSolder
R3, R5, R7, R9, R11, R13, R15, R17, R19, R21, R23, R25, R27, R29, R31, R33, R35, R37, R39, R41, R43, R45, R47, R49, R51, R53, R55, R57, R59, R61, R63, R65, R67, R69, R71, R73, R75, R77, R79, R81, R83, R85, R87, R89, R91, R93, R95, R97: 4.7k; R_0805_2012Metric_Pad1.15x1.40mm_HandSolder
R4, R6, R8, R10, R12, R14, R16, R18, R20, R22, R24, R26, R28, R30, R32, R34, R36, R38, R40, R42, R44, R46, R48, R50, R52, R54, R56, R58, R60, R62, R64, R66, R68, R70, R72, R74, R76, R78, R80, R82, R84, R86, R88, R90, R92, R94, R96, R98: 220R; R_0805_2012Metric_Pad1.15x1.40mm_HandSolder
SW1: MT-0-102-A101-M200-RS+PJ; SW-TH_MT-0-103-A101-M200-RS
SW2, SW3: TS4535TP 250GF 009; SW-SMD_4P-L4.5-W4.5-P3.00-LS6.8

Connections:
+3V3: ADC1.8 (VDD), ADC2.8 (VDD), AMUX1.24 (VCC), AMUX2.24 (VCC), AMUX3.24 (VCC), C4.2, DMUX1.9 (VDD), DMUX2.9 (VDD), JP1.3 (B), JP2.3 (B), JP3.3 (B), JP4.3 (B), JP5.3 (B), JP6.3 (B), JP7.3 (B), JP8.3 (B), LDO1.2 (VO), LIGHTGATE1.3, LOADCELL1.4, MCU1.35 (ADC_VREF), MOUSE_FPC1.7, MOUSE_FPC2.7, PR1.1 (C), PR2.1 (C), PR3.1 (C), PR4.1 (C), PR5.1 (C), PR6.1 (C), PR7.1 (C), PR8.1 (C), PR9.1 (C), PR10.1 (C), PR11.1 (C), PR12.1 (C), PR13.1 (C), PR14.1 (C), PR15.1 (C), PR16.1 (C), PR17.1 (C), PR18.1 (C), PR19.1 (C), PR20.1 (C), PR21.1 (C), PR22.1 (C), PR23.1 (C), PR24.1 (C), PR25.1 (C), PR26.1 (C), PR27.1 (C), PR28.1 (C), PR29.1 (C), PR30.1 (C), PR31.1 (C), PR32.1 (C), PR33.1 (C), PR34.1 (C), PR35.1 (C), PR36.1 (C), PR37.1 (C), PR38.1 (C), PR39.1 (C), PR40.1 (C), PR41.1 (C), PR42.1 (C), PR43.1 (C), PR44.1 (C), PR45.1 (C), PR46.1 (C), PR47.1 (C), PR48.1 (C), R1.1, R2.1
+5V: BUCK1.3 (OUT+), C2.2, C3.2, GATE_LED1.2, LDO1.3 (VI), LED1.2 (A), LED2.2 (A), LED3.2 (A), LED4.2 (A), LED5.2 (A), LED6.2 (A), LED7.2 (A), LED8.2 (A), LED9.2 (A), LED10.2 (A), LED11.2 (A), LED12.2 (A), LED13.2 (A), LED14.2 (A), LED15.2 (A), LED16.2 (A), LED17.2 (A), LED18.2 (A), LED19.2 (A), LED20.2 (A), LED21.2 (A), LED22.2 (A), LED23.2 (A), LED24.2 (A), LED25.2 (A), LED26.2 (A), LED27.2 (A), LED28.2 (A), LED29.2 (A), LED30.2 (A), LED31.2 (A), LED32.2 (A), LED33.2 (A), LED34.2 (A), LED35.2 (A), LED36.2 (A), LED37.2 (A), LED38.2 (A), LED39.2 (A), LED40.2 (A), LED41.2 (A), LED42.2 (A), LED43.2 (A), LED44.2 (A), LED45.2 (A), LED46.2 (A), LED47.2 (A), LED48.2 (A), MCU1.39 (VSYS)
/ADC_INT1: ADC1.2 (ALERT/RDY), DMUX2.6 (GPB5)
/ADC_INT2: ADC2.2 (ALERT/RDY), DMUX2.7 (GPB6)
/AMUX_EN: AMUX1.15 (~E), AMUX2.15 (~E), AMUX3.15 (~E), DMUX2.28 (GPA7)
/AMUX_S0: AMUX1.10 (S0), AMUX2.10 (S0), AMUX3.10 (S0), DMUX1.25 (GPA4)
/AMUX_S1: AMUX1.11 (S1), AMUX2.11 (S1), AMUX3.11 (S1), DMUX1.26 (GPA5)
/AMUX_S2: AMUX1.14 (S2), AMUX2.14 (S2), AMUX3.14 (S2), DMUX1.27 (GPA6)
/AMUX_S3: AMUX1.13 (S3), AMUX2.13 (S3), AMUX3.13 (S3), DMUX1.28 (GPA7)
/DMUX1_INT: DMUX1.20 (INTA), MCU1.25 (GPIO19)
/DMUX2_INT: DMUX2.8 (GPB7), DMUX2.20 (INTA)
/DMUX_RESET: DMUX1.18 (~RESET), DMUX2.18 (~RESET), MCU1.26 (GPIO20)
/DMUX_SCS: DMUX1.11 (~CS), DMUX2.11 (~CS), MCU1.27 (GPIO21)
/DRV1_IN1: DRV1.4 (IN1), MCU1.9 (GPIO6)
/DRV1_IN2: DRV1.3 (IN2), MCU1.10 (GPIO7)
/DRV1_IPROPI: ADC2.6 (AIN2), DRV1.10 (IPROPI)
/DRV1_NFAULT: DMUX2.1 (GPB0), DRV1.9 (NFAULT)
/DRV1_NSLEEP: DMUX1.2 (GPB1), DRV1.11 (NSLEEP)
/DRV1_OFF: DMUX1.1 (GPB0), DRV1.5 (DRVOFF)
/DRV1_SCS: DMUX2.21 (GPA0), DRV1.2 (SCS)
/DRV2_IN1: DRV2.4 (IN1), MCU1.11 (GPIO8)
/DRV2_IN2: DRV2.3 (IN2), MCU1.12 (GPIO9)
/DRV2_IPROPI: ADC1.4 (AIN0), DRV2.10 (IPROPI)
/DRV2_NFAULT: DMUX2.2 (GPB1), DRV2.9 (NFAULT)
/DRV2_NSLEEP: DMUX1.4 (GPB3), DRV2.11 (NSLEEP)
/DRV2_OFF: DMUX1.3 (GPB2), DRV2.5 (DRVOFF)
/DRV2_SCS: DMUX2.22 (GPA1), DRV2.2 (SCS)
/DRV3_IN1: DRV3.4 (IN1), MCU1.14 (GPIO10)
/DRV3_IN2: DRV3.3 (IN2), MCU1.15 (GPIO11)
/DRV3_IPROPI: ADC1.7 (AIN3), DRV3.10 (IPROPI)
/DRV3_NFAULT: DMUX2.3 (GPB2), DRV3.9 (NFAULT)
/DRV3_NSLEEP: DMUX1.6 (GPB5), DRV3.11 (NSLEEP)
/DRV3_OFF: DMUX1.5 (GPB4), DRV3.5 (DRVOFF)
/DRV3_SCS: DMUX2.23 (GPA2), DRV3.2 (SCS)
/DRV4_IN1: DRV4.4 (IN1), MCU1.16 (GPIO12)
/DRV4_IN2: DRV4.3 (IN2), MCU1.17 (GPIO13)
/DRV4_IPROPI: ADC2.7 (AIN3), DRV4.10 (IPROPI)
/DRV4_NFAULT: DMUX2.4 (GPB3), DRV4.9 (NFAULT)
/DRV4_NSLEEP: DMUX1.8 (GPB7), DRV4.11 (NSLEEP)
/DRV4_OFF: DMUX1.7 (GPB6), DRV4.5 (DRVOFF)
/DRV4_SCS: DMUX2.24 (GPA3), DRV4.2 (SCS)
/DRV5_IN1: DRV5.4 (IN1), MCU1.19 (GPIO14)
/DRV5_IN2: DRV5.3 (IN2), MCU1.20 (GPIO15)
/DRV5_IPROPI: ADC1.6 (AIN2), DRV5.10 (IPROPI)
/DRV5_NFAULT: DMUX2.5 (GPB4), DRV5.9 (NFAULT)
/DRV5_NSLEEP: DMUX2.27 (GPA6), DRV5.11 (NSLEEP)
/DRV5_OFF: DMUX2.26 (GPA5), DRV5.5 (DRVOFF)
/DRV5_SCS: DMUX2.25 (GPA4), DRV5.2 (SCS)
/EN: CTRL1.2, MCU1.37 (3V3_EN), SW3.3, SW3.4
/GATE: ADC1.5 (AIN1), LIGHTGATE1.2
/I2C0.SCL: ADC1.10 (SCL), ADC2.10 (SCL), MCU1.2 (GPIO1), R2.2
/I2C0.SDA: ADC1.9 (SDA), ADC2.9 (SDA), MCU1.1 (GPIO0), R1.2
/KICK: KICK1.3 (KICK), MCU1.24 (GPIO18)
/LOADCELL_A+: ADC2.5 (AIN1), LOADCELL1.3
/LOADCELL_A-: ADC2.4 (AIN0), LOADCELL1.2
/MOUSE1_MOT: MCU1.29 (GPIO22), MOUSE_FPC1.5
/MOUSE1_RST: DMUX1.23 (GPA2), MOUSE_FPC1.6
/MOUSE1_SCS: DMUX1.21 (GPA0), MOUSE_FPC1.3
/MOUSE2_MOT: MCU1.7 (GPIO5), MOUSE_FPC2.5
/MOUSE2_RST: DMUX1.24 (GPA3), MOUSE_FPC2.6
/MOUSE2_SCS: DMUX1.22 (GPA1), MOUSE_FPC2.3
/RUN: CTRL1.1, MCU1.30 (RUN), SW2.3, SW2.4
/RX0: CTRL1.3, MCU1.22 (GPIO17)
/SPI0.MISO: DMUX1.14 (SO), DMUX2.14 (SO), DRV1.8 (SDO), DRV2.8 (SDO), DRV3.8 (SDO), DRV4.8 (SDO), DRV5.8 (SDO), MCU1.6 (GPIO4), MOUSE_FPC1.2, MOUSE_FPC2.2
/SPI0.MOSI: DMUX1.13 (SI), DMUX2.13 (SI), DRV1.7 (SDI), DRV2.7 (SDI), DRV3.7 (SDI), DRV4.7 (SDI), DRV5.7 (SDI), MCU1.5 (GPIO3), MOUSE_FPC1.1, MOUSE_FPC2.1
/SPI0.SCLK: DMUX1.12 (SCK), DMUX2.12 (SCK), DRV1.1 (SCLK), DRV2.1 (SCLK), DRV3.1 (SCLK), DRV4.1 (SCLK), DRV5.1 (SCLK), MCU1.4 (GPIO2), MOUSE_FPC1.4, MOUSE_FPC2.4
/TX0: CTRL1.4, MCU1.21 (GPIO16)
/line sensor array 1/LS1: AMUX1.2 (I7), PR1.2 (E), R3.1
/line sensor array 1/LS2: AMUX1.3 (I6), PR2.2 (E), R5.1
/line sensor array 1/LS3: AMUX1.4 (I5), PR3.2 (E), R7.1
/line sensor array 1/LS4: AMUX1.5 (I4), PR4.2 (E), R9.1
/line sensor array 1/LS5: AMUX1.6 (I3), PR5.2 (E), R11.1
/line sensor array 1/LS6: AMUX1.7 (I2), PR6.2 (E), R13.1
/line sensor array 1/LS7: AMUX1.8 (I1), PR7.2 (E), R15.1
/line sensor array 1/LS8: AMUX1.9 (I0), PR8.2 (E), R17.1
/line sensor array 1/LS9: AMUX1.23 (I8), PR9.2 (E), R19.1
/line sensor array 1/LS10: AMUX1.22 (I9), PR10.2 (E), R21.1
/line sensor array 1/LS11: AMUX1.21 (I10), PR11.2 (E), R23.1
/line sensor array 1/LS12: AMUX1.20 (I11), PR12.2 (E), R25.1
/line sensor array 1/LS13: AMUX1.19 (I12), PR13.2 (E), R27.1
/line sensor array 1/LS14: AMUX1.18 (I13), PR14.2 (E), R29.1
/line sensor array 1/LS15: AMUX1.17 (I14), PR15.2 (E), R31.1
/line sensor array 1/LS16: AMUX1.16 (I15), PR16.2 (E), R33.1
/line sensor array 2/LS1: AMUX2.2 (I7), PR17.2 (E), R35.1
/line sensor array 2/LS2: AMUX2.3 (I6), PR18.2 (E), R37.1
/line sensor array 2/LS3: AMUX2.4 (I5), PR19.2 (E), R39.1
/line sensor array 2/LS4: AMUX2.5 (I4), PR20.2 (E), R41.1
/line sensor array 2/LS5: AMUX2.6 (I3), PR21.2 (E), R43.1
/line sensor array 2/LS6: AMUX2.7 (I2), PR22.2 (E), R45.1
/line sensor array 2/LS7: AMUX2.8 (I1), PR23.2 (E), R47.1
/line sensor array 2/LS8: AMUX2.9 (I0), PR24.2 (E), R49.1
/line sensor array 2/LS9: AMUX2.23 (I8), PR25.2 (E), R51.1
/line sensor array 2/LS10: AMUX2.22 (I9), PR26.2 (E), R53.1
/line sensor array 2/LS11: AMUX2.21 (I10), PR27.2 (E), R55.1
/line sensor array 2/LS12: AMUX2.20 (I11), PR28.2 (E), R57.1
/line sensor array 2/LS13: AMUX2.19 (I12), PR29.2 (E), R59.1
/line sensor array 2/LS14: AMUX2.18 (I13), PR30.2 (E), R61.1
/line sensor array 2/LS15: AMUX2.17 (I14), PR31.2 (E), R63.1
/line sensor array 2/LS16: AMUX2.16 (I15), PR32.2 (E), R65.1
/line sensor array 3/LS1: AMUX3.2 (I7), PR33.2 (E), R67.1
/line sensor array 3/LS2: AMUX3.3 (I6), PR34.2 (E), R69.1
/line sensor array 3/LS3: AMUX3.4 (I5), PR35.2 (E), R71.1
/line sensor array 3/LS4: AMUX3.5 (I4), PR36.2 (E), R73.1
/line sensor array 3/LS5: AMUX3.6 (I3), PR37.2 (E), R75.1
/line sensor array 3/LS6: AMUX3.7 (I2), PR38.2 (E), R77.1
/line sensor array 3/LS7: AMUX3.8 (I1), PR39.2 (E), R79.1
/line sensor array 3/LS8: AMUX3.9 (I0), PR40.2 (E), R81.1
/line sensor array 3/LS9: AMUX3.23 (I8), PR41.2 (E), R83.1
/line sensor array 3/LS10: AMUX3.22 (I9), PR42.2 (E), R85.1
/line sensor array 3/LS11: AMUX3.21 (I10), PR43.2 (E), R87.1
/line sensor array 3/LS12: AMUX3.20 (I11), PR44.2 (E), R89.1
/line sensor array 3/LS13: AMUX3.19 (I12), PR45.2 (E), R91.1
/line sensor array 3/LS14: AMUX3.18 (I13), PR46.2 (E), R93.1
/line sensor array 3/LS15: AMUX3.17 (I14), PR47.2 (E), R95.1
/line sensor array 3/LS16: AMUX3.16 (I15), PR48.2 (E), R97.1
AMUX1_COM: AMUX1.1 (COM), MCU1.31 (GPIO26_ADC0)
AMUX2_COM: AMUX2.1 (COM), MCU1.32 (GPIO27_ADC1)
AMUX3_COM: AMUX3.1 (COM), MCU1.34 (GPIO28_ADC2)
GND: ADC1.3 (GND), ADC2.3 (GND), AMUX1.12 (GND), AMUX2.12 (GND), AMUX3.12 (GND), BUCK1.2 (IN-), BUCK1.4 (OUT-), C1.2, C2.1, C3.1, C4.1, DMUX1.10 (VSS), DMUX2.10 (VSS), DRV1.6 (GND), DRV2.6 (GND), DRV3.6 (GND), DRV4.6 (GND), DRV5.6 (GND), GATE_LED1.1, JP1.1 (A), JP2.1 (A), JP3.1 (A), JP4.1 (A), JP5.1 (A), JP6.1 (A), JP7.1 (A), JP8.1 (A), KICK1.2 (GND), LDO1.1 (GND), LIGHTGATE1.1, LOADCELL1.1, MCU1.3 (GND), MCU1.8 (GND), MCU1.13 (GND), MCU1.18 (GND), MCU1.23 (GND), MCU1.28 (GND), MCU1.33 (AGND), MCU1.38 (GND), MOUSE_FPC1.8, MOUSE_FPC2.8, PWR1.1, PWR2.1, R3.2, R4.1, R5.2, R6.1, R7.2, R8.1, R9.2, R10.1, R11.2, R12.1, R13.2, R14.1, R15.2, R16.1, R17.2, R18.1, R19.2, R20.1, R21.2, R22.1, R23.2, R24.1, R25.2, R26.1, R27.2, R28.1, R29.2, R30.1, R31.2, R32.1, R33.2, R34.1, R35.2, R36.1, R37.2, R38.1, R39.2, R40.1, R41.2, R42.1, R43.2, R44.1, R45.2, R46.1, R47.2, R48.1, R49.2, R50.1, R51.2, R52.1, R53.2, R54.1, R55.2, R56.1, R57.2, R58.1, R59.2, R60.1, R61.2, R62.1, R63.2, R64.1, R65.2, R66.1, R67.2, R68.1, R69.2, R70.1, R71.2, R72.1, R73.2, R74.1, R75.2, R76.1, R77.2, R78.1, R79.2, R80.1, R81.2, R82.1, R83.2, R84.1, R85.2, R86.1, R87.2, R88.1, R89.2, R90.1, R91.2, R92.1, R93.2, R94.1, R95.2, R96.1, R97.2, R98.1, SW1.3, SW2.1, SW2.2, SW3.1, SW3.2
unnamed: ADC1.1 (ADDR), JP7.2 (C)
unnamed: ADC2.1 (ADDR), JP8.2 (C)
unnamed: BUCK1.1 (IN+), C1.1, SW1.2
unnamed: DMUX1.15 (A0), JP1.2 (C)
unnamed: DMUX1.16 (A1), JP2.2 (C)
unnamed: DMUX1.17 (A2), JP3.2 (C)
unnamed: DMUX2.15 (A0), JP4.2 (C)
unnamed: DMUX2.16 (A1), JP5.2 (C)
unnamed: DMUX2.17 (A2), JP6.2 (C)
unnamed: LED1.1 (K), R4.2
unnamed: LED2.1 (K), R6.2
unnamed: LED3.1 (K), R8.2
unnamed: LED4.1 (K), R10.2
unnamed: LED5.1 (K), R12.2
unnamed: LED6.1 (K), R14.2
unnamed: LED7.1 (K), R16.2
unnamed: LED8.1 (K), R18.2
unnamed: LED9.1 (K), R20.2
unnamed: LED10.1 (K), R22.2
unnamed: LED11.1 (K), R24.2
unnamed: LED12.1 (K), R26.2
unnamed: LED13.1 (K), R28.2
unnamed: LED14.1 (K), R30.2
unnamed: LED15.1 (K), R32.2
unnamed: LED16.1 (K), R34.2
unnamed: LED17.1 (K), R36.2
unnamed: LED18.1 (K), R38.2
unnamed: LED19.1 (K), R40.2
unnamed: LED20.1 (K), R42.2
unnamed: LED21.1 (K), R44.2
unnamed: LED22.1 (K), R46.2
unnamed: LED23.1 (K), R48.2
unnamed: LED24.1 (K), R50.2
unnamed: LED25.1 (K), R52.2
unnamed: LED26.1 (K), R54.2
unnamed: LED27.1 (K), R56.2
unnamed: LED28.1 (K), R58.2
unnamed: LED29.1 (K), R60.2
unnamed: LED30.1 (K), R62.2
unnamed: LED31.1 (K), R64.2
unnamed: LED32.1 (K), R66.2
unnamed: LED33.1 (K), R68.2
unnamed: LED34.1 (K), R70.2
unnamed: LED35.1 (K), R72.2
unnamed: LED36.1 (K), R74.2
unnamed: LED37.1 (K), R76.2
unnamed: LED38.1 (K), R78.2
unnamed: LED39.1 (K), R80.2
unnamed: LED40.1 (K), R82.2
unnamed: LED41.1 (K), R84.2
unnamed: LED42.1 (K), R86.2
unnamed: LED43.1 (K), R88.2
unnamed: LED44.1 (K), R90.2
unnamed: LED45.1 (K), R92.2
unnamed: LED46.1 (K), R94.2
unnamed: LED47.1 (K), R96.2
unnamed: LED48.1 (K), R98.2
VCC: DRV1.12 (VMOT), DRV2.12 (VMOT), DRV3.12 (VMOT), DRV4.12 (VMOT), DRV5.12 (VMOT), KICK1.1 (VCC), PWR1.2, PWR2.2, SW1.1
