Froggy111/RBC-soccer-2025/hardware/motor-driver/pcb/motor-driver.kicad_pcb

## KiCad design hardware/motor-driver/pcb/motor-driver.kicad_pcb (2024-12-16)

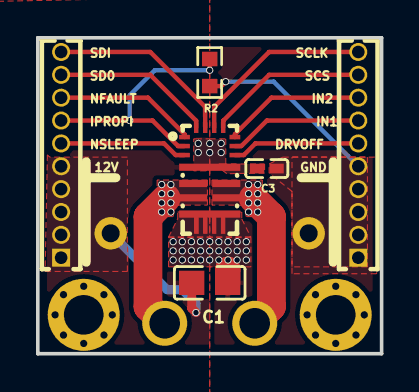
[picture p26: board motor-driver.kicad_pcb from above]

Board: 2 copper layers, 19.1 x 17.6 mm, 9 parts (1 on the bottom side), 14 nets.

Parts:
C1: 22uF; C0805
C3: 100nF; C0402
DRV8244: DRV8244SQRYJRQ1; VQFN-16_L6.0-W3.0-P0.50-TL
M2_1, M2_2: M2
R2: 680Ω; R0603
U1: XT30PW-F; CONN-TH_XT30PW-F-1
U2, U3: X1311WV-10J-C40D24; HDR-TH_10P-P1.27-V-M

Connections:
12V: C1.1, C3.1, DRV8244.4, U1.4, U3.1, U3.2, U3.3, U3.4, U3.5
DRVOFF: DRV8244.10, U2.6
GND: C1.2, C3.2, DRV8244.7, R2.2, U1.3, U2.1, U2.2, U2.3, U2.4, U2.5
IN1: DRV8244.11, U2.7
IN2: DRV8244.12, U2.8
IPROPI: DRV8244.2, R2.1, U3.7
NFAULT: DRV8244.1, U3.8
NSLEEP: DRV8244.3, U3.6
OUT1: DRV8244.8, DRV8244.9, U1.2
OUT2: DRV8244.5, DRV8244.6, U1.1
SCLK: DRV8244.14, U2.10
SCS: DRV8244.13, U2.9
SDI: DRV8244.15, U3.10
SDO: DRV8244.16, U3.9
