Froggy111/RBC-soccer-2025/hardware/mouse-sensor/pcb/pcb.kicad_pcb

## KiCad design hardware/mouse-sensor/pcb/pcb.kicad_pcb (2024-12-10)

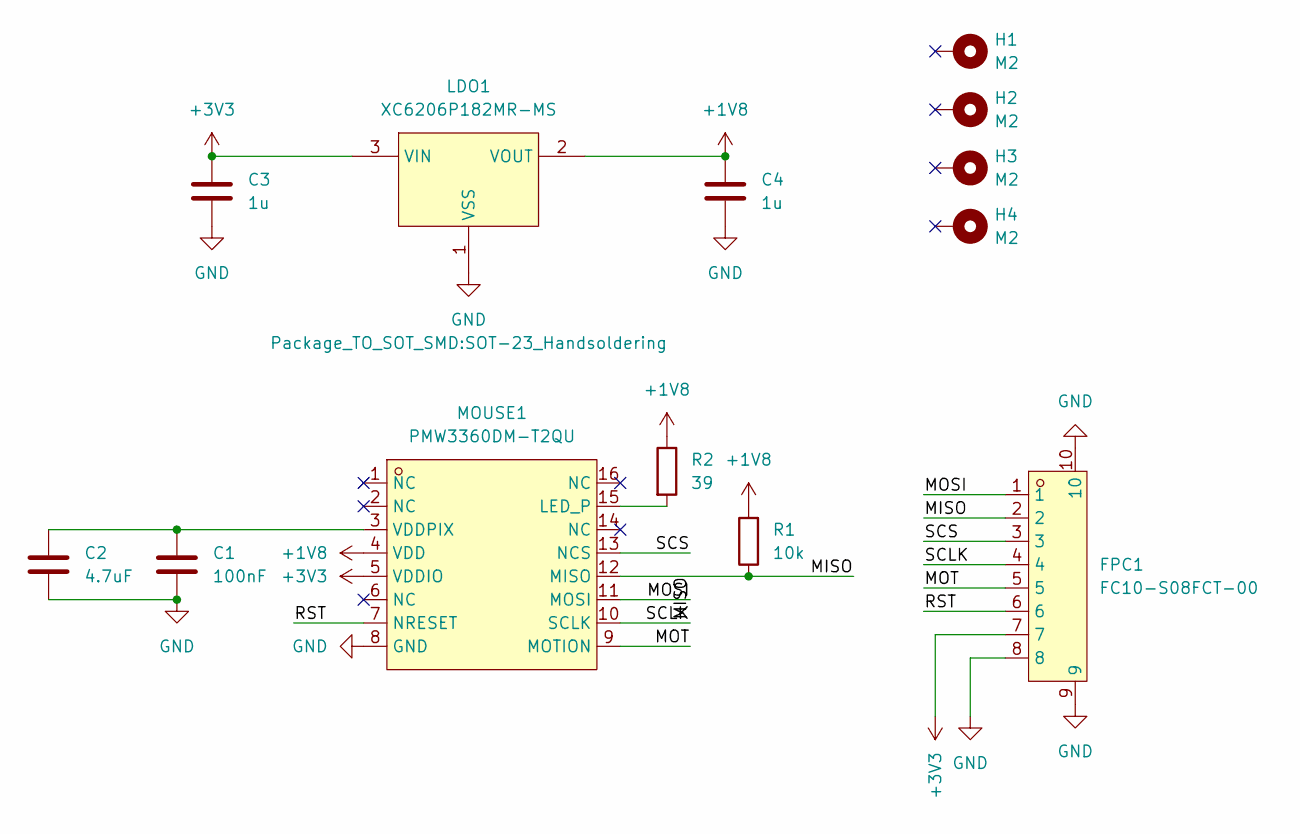
[picture p27: schematic pcb.kicad_sch]

Parts:
C1: 100nF; C_0805_2012Metric_Pad1.18x1.45mm_HandSolder
C2: 4.7uF; C_0805_2012Metric_Pad1.18x1.45mm_HandSolder
C3, C4: 1u; C_0805_2012Metric_Pad1.18x1.45mm_HandSolder
FPC1: FC10-S08FCT-00; FPC-SMD_8P-P1.00_DEALON_FC10-S08FCT-00; LCSC Part C2998898
H1, H2, H3, H4: M2; MountingHole_2.2mm_M2_Pad_Via
LDO1: XC6206P182MR-MS; SOT-23_Handsoldering; LCSC Part C5252894
MOUSE1: PMW3360DM-T2QU; PDIP-16_L16.2-W9.1-P1.78-TL_PMW3389DM-T3QU; LCSC Part C20612443
R1: 10k; R_0805_2012Metric_Pad1.15x1.40mm_HandSolder
R2: 39; R_0805_2012Metric_Pad1.15x1.40mm_HandSolder

Connections:
+1V8: C4.1, LDO1.2 (VOUT), MOUSE1.4 (VDD), R1.2, R2.1
+3V3: C3.1, FPC1.7, LDO1.3 (VIN), MOUSE1.5 (VDDIO)
/MISO: FPC1.2, MOUSE1.12 (MISO), R1.1
/MOSI: FPC1.1, MOUSE1.11 (MOSI)
/MOT: FPC1.5, MOUSE1.9 (MOTION)
/RST: FPC1.6, MOUSE1.7 (NRESET)
/SCLK: FPC1.4, MOUSE1.10 (SCLK)
/SCS: FPC1.3, MOUSE1.13 (NCS)
GND: C1.2, C2.2, C3.2, C4.2, FPC1.8, FPC1.9, FPC1.10, LDO1.1 (VSS), MOUSE1.8 (GND)
unnamed: MOUSE1.15 (LED_P), R2.2
unnamed: C1.1, C2.1, MOUSE1.3 (VDDPIX)

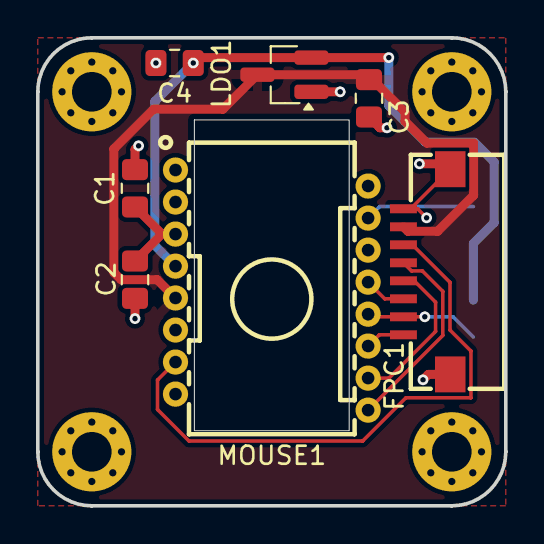
[picture p28: board hardware/mouse-sensor/pcb/pcb.kicad_pcb from above]

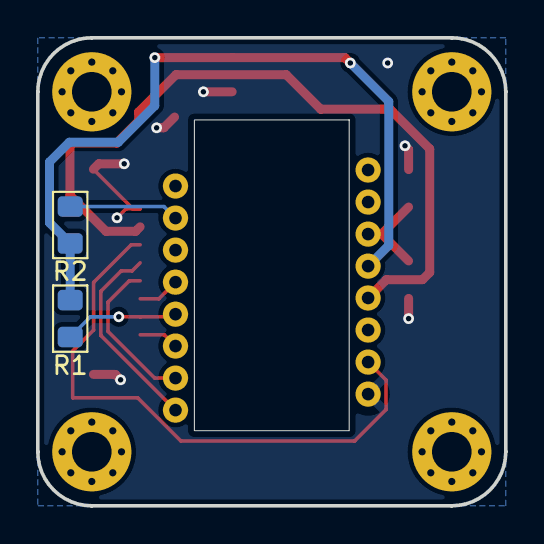
[picture p29: board hardware/mouse-sensor/pcb/pcb.kicad_pcb from below]

Board: 2 copper layers, 26.0 x 26.0 mm, 13 parts (2 on the bottom side), 11 nets.
