Froggy111/RBC-soccer-2025/software/top/configs/include/config.hpp

#pragma once

#define IMU_POLL_INTERVAL 1
#define IMU_FSR 8 // 8 Gs max acceleration

#define LED_COUNT 16
#define CFG_TUSB_VID 0x2E8A
#define CFG_TUSB_PID 0xFFF0
// #define IS_BOTTOM_PICO
// #define IS_MIDDLE_PICO
#define IS_TOP_PICO
#define PING_PACKET_MAX_SIZE 128
