Froggy111/RBC-soccer-2025/(commit log)

2024-04-18 uhh is die
2024-04-22 ⚡ General Update: Update gitignore and arrange files
2024-04-23 mass is screwed
2024-04-30 pcb stuff
2024-06-03 added docs for bottom plate
2024-06-03 documented top plate, added and fixed documentation for bottom plate
2024-06-04 🐛 FIX: resources are shared
2024-06-04 📖 DOC: Updated hardware PCB documentation based on new plan
2024-06-17 updated top plate pinouts
2024-06-17 updated bottom plate pinouts
2024-07-15 added mirror STL generation
2024-10-07 :bug: Refractor to remove global vars and pass by lambda
    [main.cpp]
2024-10-07 :bug: Fix import errors
    [main.cpp]
2024-10-09 mouse sensor init
2024-10-09 :alembic: Revert back to async!
    [main.cpp]
2024-10-16 :bug: Clean up a little bit
    [main.cpp]
2024-10-23 :sparkles: Try implementing some kinematics
2024-10-25 added motor driver test and fixed my idiocy
    [main.cpp]
2024-10-27 added moving average to simple motor driver test
2024-10-27 made it print to the display
2024-10-30 Fixed up mirror gen
    [main.cpp]
2024-11-08 :art: Clean up motor-driver-test code
2024-11-10 PMW3360 lib with liftoff calibration, and work on new mouse sensor PCB
    [project1.kicad_pcb, project1.kicad_sch]
2024-11-12 compact mouse sensor board design
    [iter1.kicad_pcb, iter1.kicad_sch, project1.kicad_pcb, project1.kicad_sch]
2024-11-12 symmetric handsolderable less compact mouse sensor breakout
    [iter1.kicad_pcb, iter1.kicad_sch]
2024-11-12 :sparkles: Add printing
2024-11-20 :zap: Restore the old motor driver code
2024-11-24 :art: Rename esp32
2024-11-27 idk why ch201 not working
    [main.cpp]
2024-12-05 init bottom plate pcb
    [bottom-plate-pcb.kicad_pcb, bottom-plate-pcb.kicad_sch]
2024-12-05 :sparkles: Create top-plate
    [top-plate.kicad_pcb, top-plate.kicad_sch]
2024-12-10 mostly done with bottom plate schematic
    [bottom-plate-pcb.kicad_pcb, bottom-plate-pcb.kicad_sch, iter1.kicad_pcb, iter1.kicad_sch]
2024-12-10 i have a git skill issue
    [line_sensors.kicad_sch, motor-driver.kicad_pcb, motor-driver.kicad_sch, pcb-Edge_Cuts.dxf, pcb.kicad_pcb, pcb.kicad_sch]
2024-12-15 bottom plate schematic, and removed some random stuff
    [LEDs.kicad_sch, line_sensors.kicad_sch, motor-driver.kicad_pcb, pcb.kicad_pcb, pcb.kicad_sch, power.kicad_sch]
2024-12-16 layed out fully symmetric kicker module. unfortunately, it is too long :(
    [boost.kicad_pcb, boost.kicad_sch, boost.step, motor-driver.kicad_pcb, pcb.kicad_pcb, pcb.kicad_sch]
2024-12-17 quite a few changes
    [pcb.kicad_pcb, pcb.kicad_sch]
2024-12-20 kicker pcb done, working on bottom plate
    [LEDs.kicad_sch, boost.kicad_pcb, boost.kicad_sch, boost.step, line_sensors.kicad_sch, pcb.kicad_pcb, pcb.kicad_sch, power.kicad_sch]
2024-12-21 cleaned up bottom plate schematic and added explanations of design decisions. Please read.
    [LEDs.kicad_sch, light-sensor-1.kicad_sch, light-sensor.kicad_sch, line-sensor-array.kicad_sch, line_sensors.kicad_sch, pcb.kicad_pcb, pcb.kicad_sch, power.kicad_sch]
2024-12-21 cleaned up bottom plate schematic numbering
    [light-sensor.kicad_sch, line-sensor-array.kicad_sch, pcb.kicad_pcb, pcb.kicad_sch]
2024-12-22 fixed non convention following of kicker pcb
    [light-sensor.kicad_sch, line-sensor-array.kicad_sch, pcb.kicad_pcb, pcb.kicad_sch]
2024-12-22 made copper zone connections solid
    [LEDs.kicad_sch, light-sensor-1.kicad_sch, line_sensors.kicad_sch, pcb.kicad_pcb, power.kicad_sch]
2024-12-23 fixed line sensor positions
    [light-sensor.kicad_sch, line-sensor-array-1.kicad_sch, line-sensor-array-2.kicad_sch, line-sensor-array-3.kicad_sch, line-sensor-array.kicad_sch, pcb.kicad_pcb, pcb.kicad_sch]
2024-12-24 completed bottom pcb
    [light-sensor.kicad_sch, line-sensor-array-1.kicad_sch, line-sensor-array-2.kicad_sch, line-sensor-array-3.kicad_sch, pcb.kicad_sch]
2024-12-24 updated bottom plate docs, and added some labels on bottom pcb
2024-12-24 lightened up bottom plate generated step file
2024-12-28 added testpoints and fixed issues with bottom plate
    [pcb.kicad_sch]
2024-12-31 finished middle plate schematic, working on placements
    [middle-plate.kicad_pcb, middle-plate.kicad_sch]
2024-12-31 some misc bottom plate changes
    [light-sensor.kicad_sch, pcb.kicad_sch]
2024-12-31 changed kicker mosfet footprint to have mosfet sit flush. Not good practice, but necessary to ensure clearance if middle plate is to be moved down.
    [pcb.kicad_pcb]
2024-12-31 rough layout of middle plate, moved files to standardise
    [middle-plate.kicad_pcb, middle-plate.kicad_sch, pcb.kicad_pcb, pcb.kicad_sch]
2025-01-02 Some top plate stuff
    [CH201.kicad_sch, ch201.kicad_sch, top-plate.kicad_sch]
2025-01-02 :sparkles: Done with top plate?
    [CH201.kicad_sch, top-plate.kicad_sch]
2025-01-02 middle plate completed other than cutouts
    [pcb.kicad_pcb, pcb.kicad_sch]
2025-01-02 fixed naming and structure
    [CH201.kicad_sch, ch201.kicad_sch, pcb.kicad_pcb, pcb.kicad_sch]
2025-01-02 Revert "fixed naming and structure"
    This reverts commit 85cb8a6d80e828be1fe4c6e36d316d3d322d80a6.
    [CH201.kicad_sch, ch201.kicad_sch, pcb.kicad_sch, top-plate.kicad_pcb, top-plate.kicad_sch]
2025-01-02 cleaned up files
    [CH201.kicad_sch, ch201.kicad_sch, top-plate.kicad_pcb, top-plate.kicad_sch]
2025-01-02 changed some reference designators, and cleaned up schematics
    [pcb.kicad_pcb, pcb.kicad_sch]
2025-01-02 funny thing
    [pcb.kicad_sch]
2025-01-02 Add holes
    [pcb.kicad_pcb]
2025-01-03 fixed middle plate and added stuff to gitignore
    [CH201.kicad_sch, pcb.kicad_pcb, pcb.kicad_sch]
2025-01-03 top plate schematic
    [CH201.kicad_sch, pcb.kicad_sch]
2025-01-03 boom explosion
    [pcb.kicad_pcb]
2025-01-06 Symbols for top plate
2025-01-07 :sparkles: Footprints
2025-01-07 added ch201 module
    [CH201.kicad_sch, pcb.kicad_pcb, pcb.kicad_sch, pcb.step]
2025-01-08 fixed up symbols for oled and ultrasound
    [pcb.kicad_sch]
2025-01-08 fixed up symbols and footprints for top plate, and completed top plate schematic (other than modifications for better routing)
    [CH201.kicad_sch, pcb.kicad_sch]
2025-01-08 ICM20948 footprint, fixed some stuff
    [CH201.kicad_sch, pcb.kicad_sch]
2025-01-08 some top plate changes
    [CH201.kicad_sch, pcb.kicad_pcb, pcb.kicad_sch]
2025-01-08 fixed up bottom plate schematic. do not run a global symbol update! all modified symbols as of now are intentionally modified locally.
    [CH201.kicad_sch, pcb.kicad_pcb, pcb.kicad_sch]
2025-01-08 added fuse to bottom plate
    [pcb.kicad_pcb, pcb.kicad_sch]
2025-01-08 added fuse to middle plate and fixed switches 3d view
    [pcb.kicad_pcb, pcb.kicad_sch]
2025-01-08 Correct hole labelling for both plates
    [pcb.kicad_pcb]
2025-01-08 label a bunch
    [pcb.kicad_pcb]
2025-01-09 top pcb completed
    [CH201.kicad_sch, pcb.kicad_pcb, pcb.kicad_sch]
2025-01-09 labelled bottom middle and top pcbs, added testpoints
    [pcb.kicad_pcb, pcb.kicad_sch]
2025-01-09 fixed motor driver footprint (one header had markings on bottom surface for some reason), generated production files
    [bom.csv, designators.csv, light-sensor.kicad_sch, pcb.kicad_pcb, pcb.kicad_pcb_bom.csv, pcb.kicad_pcb_positions.csv, positions.csv]
2025-01-09 fixed typo in top plate
    [pcb.kicad_pcb]
2025-01-17 added capacitors for motor drivers
    [bom.csv, designators.csv, light-sensor.kicad_sch, pcb.kicad_sch, positions.csv]
2025-02-04 :recycle: Refine CMake for bottom pico
2025-02-04 :sparkles: Add CMake for Motor Drivers too!
2025-02-05 removed global labels from bottom plate schematic (forgot to remove it)
    [light-sensor.kicad_sch, line-sensor-array-1.kicad_sch, line-sensor-array-2.kicad_sch, line-sensor-array-3.kicad_sch, pcb.kicad_sch]
2025-02-05 :sparkles: MIDDLE PLATE AHH I HATE CMAKE
2025-02-05 Revert "fixed clangd issues"
    This reverts commit a2d8e6f5218a34162382f802a37f80550e8d3f4b.
    [main.c]
2025-02-06 fixed icm20948 footprint (header positions were a tiny bit off)
    [pcb.kicad_pcb]
2025-02-06 fixed up top pcb (icm20948 and oled were overlapping)
    [pcb.kicad_pcb]
2025-02-07 added 3d models for top pcb breakouts
    [pcb.kicad_pcb]
2025-02-08 changed tlv1117-33 to tlv1117-18 on top pcb for 1.8V LDO
    [CH201.kicad_sch, bom.csv, pcb.kicad_pcb, pcb.kicad_sch, positions.csv]
2025-02-08 :bug: Fix Middle Plate
2025-02-08 :recycle: Start work on new motor driver using picosdk
2025-02-09 Changes to be committed: new file: hardware/bottom-plate/pcb/~pcb.kicad_sch.lck new file: software/bottom/.gitignore modified: software/bottom/CMakeLists.txt modified: software/bottom/libs/DRV8244/DR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
2025-02-09 fixed up cmake
    [pcb.kicad_pcb]
2025-02-10 fixed up cmake v2, added bottom pcb pinmaps, fixed bottom pcb pin naming in schematic
    [pcb.kicad_sch]
2025-02-10 fixed gitignores of pcbs
2025-02-10 Changes to be committed: modified: software/bottom/libs/motor-driver/DRV8244.cpp modified: software/bottom/libs/motor-driver/pins.cpp modified: software/bottom/libs/pins/MCP23S17.cpp modified: softwa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
2025-02-14 changed res value on kicker pcb
    [pcb.kicad_pcb, pcb.kicad_sch]
2025-02-15 :sparkles: Use new pin selector systeem????
2025-02-15 kicker pcb left side pin labels was flipped
    [pcb.kicad_pcb]
2025-02-16 corrected mosfet pinout on kicker pcb (will reorder)
    [pcb.kicad_pcb, pcb.kicad_sch]
2025-02-16 :sparkles: Done with motor driver!!!!
2025-02-16 cleaned up files that shouldnt exist + kicker fabrication
    [bom.csv, positions.csv]
2025-02-16 added 45deg rotated kicker fab files (kicker design files are not rotated)
    [positions.csv]
2025-02-17 lightgate pcb
    [bom.csv, designators.csv, pcb.kicad_pcb, pcb.kicad_sch, pcb.step, positions.csv]
2025-02-18 :sparkles: debug for motor driver
2025-02-19 initial commit for line sensor algo
2025-02-19 Fix a lot of issues found by clang
    [main.cpp]
2025-02-19 line sensor libs
2025-02-19 :sparkles: MAKE PRINTF PERMANENTLY WORK
2025-02-19 :sparkles: Add newlines to printfs and do register verification
2025-02-20 updated lightgate pcb
2025-02-20 :bug: fix a ton of gpio and spi related bugs
2025-02-21 :bug: fix a couple more read write bugs i found
2025-02-21 :bug: Cleanup pin manager
2025-02-21 :zap: fix pin selector!!!! WE RECEIVING FEEDBACK
2025-02-21 :sparkles: Clean up some line sensor
2025-02-22 :sparkles: REGISTERS WORK AND MOTOR DRIVER PWM WORKS maybe
2025-02-22 :sparkles: IT WORKS! MOTOR DRIVER TEST WORKS!
2025-02-26 :ambulance: Driver works again
2025-02-26 Wrote a test main.cpp for the mouse sensor.
    It basically prints all the buffer values returned
    by the data burst mode from indices 2 to 11
    X and Y delta (combined L and H), Raw Frame Data,
    its sum, minimum and maximum,
2025-02-26 Changes to be committed: modified: software/bottom/CMakeLists.txt modified: software/bottom/libs/CMakeLists.txt modified: software/bottom/libs/mouse-sensor/CMakeLists.txt modified: software/bottom/li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
    I fixed some building issues with the PMW3360 whoops
    [main.cpp]
2025-02-27 :recycle: Refractor a whole lot of pin selector/manager
2025-02-28 Fixed PMW3360 stuff, Changed the spi read and writes to 8 bit cos i was stoopid and thought it was 16 whoops
    [main.cpp]
2025-03-02 fix printf not defined
2025-03-02 :sparkles: Add top plate config
2025-03-02 :recycle: Configure middle plates
2025-03-03 kicad stuff
2025-03-04 Same as previous commit message but I forgot to actually save the staged changes lol
2025-03-05 line sensor updated
    [light-sensor.kicad_sch, line-sensor-array-1.kicad_sch, line-sensor-array-2.kicad_sch, line-sensor-array-3.kicad_sch, pcb.kicad_sch]
2025-03-05 bottom pcb fixed, im stupid
    [light-sensor.kicad_sch, pcb.kicad_sch]
2025-03-05 actually fixed it (merging moment)
    [light-sensor.kicad_sch, line-sensor-array-1.kicad_sch, line-sensor-array-2.kicad_sch, line-sensor-array-3.kicad_sch, pcb.kicad_sch]
2025-03-06 edit mouse sensor to woerk :OOOO
2025-03-06 made printf public in usb lib
2025-03-07 added block until cdc connection to printf
2025-03-07 made printf check for cdc connection
2025-03-07 fixed 0.05mm misalignment
2025-03-07 Fixed the SCS mouse sensor 1 thingy and replaced sleep_us with busy_wait_us
2025-03-07 Actually added id to mouse sensor in pin_selector
2025-03-07 fix a bit more of line sensors
2025-03-07 print x and y delta pls or else i will commit
2025-03-08 fixed bottom pcb alspt19 and leds
    [light-sensor.kicad_sch]
2025-03-10 Wrote a basic CH201.hpp file, the cpp isnt written This is mainly just to set the skeleton for the code.
    It consists of 2 classes, a Ultrasound class for the sensors
    and UltrasoundGroup for the group itself
    The goal is to probably be able to call a method in the group
    to get all the readings of all 16 sensors in a group
    Changes to be committed:
    modified: software/top/libs/ultrasonic-sensors/CH201.cpp
    modified: software/top/libs/ultrasonic-sensors/include/CH201.hpp
2025-03-10 changed version number of bottom pcb
    [bom.csv, designators.csv, positions.csv]
2025-03-10 line sensor fixes??
2025-03-10 :sparkles: Add dmux to top plate
2025-03-10 :sparkles: Add libraries needed for top plate
2025-03-11 :sparkles: Configure dmux, comms and freertos for top plate!
2025-03-11 A small fix to the mouse sensor's read operation where it was writing 16 bits for no reason (shld be 8)
2025-03-11 Fixed some sequencing in the mouse sensor's burst mode operation
2025-03-11 made error in spi whoops, resolved now
2025-03-11 Fixed some more mouse sensor thingamajigs
    [main.cpp]
2025-03-11 sort out top plate config
2025-03-13 :bug: A bunch of improvements
    [main.cpp]
2025-03-14 :bug: Clean up mouse sensor
2025-03-14 fix pin selector
2025-03-14 more mouse sensor cleanup
2025-03-14 add v1 bottom pcb in case we need
    [bom.csv, designators.csv, light-sensor.kicad_sch, line-sensor-array-1.kicad_sch, line-sensor-array-2.kicad_sch, line-sensor-array-3.kicad_sch, pcb.kicad_pcb_bom.csv, pcb.kicad_pcb_positions.csv]
2025-03-14 More random fixer and a scanner test
    [main.cpp]
2025-03-14 fix imu
2025-03-15 FIx a few config issues
    [main.cpp]
2025-03-15 Finish imu20948?
2025-03-16 changed usb hello world test to use global cdc object to avoid confusion
    [main.cpp]
2025-03-16 Still no prints?
2025-03-16 bye global icom20948-pico
2025-03-16 fix spi read write?
    [main.cpp]
2025-03-16 IMU except magnetometer works!!
2025-03-16 :sparkles: Wait I didn't commit everything
    [main.cpp]
2025-03-16 Add opencv lib and camera test
2025-03-16 Add the docker-arm-cross-build-scripts in this repo cuz i can't fork
2025-03-17 mirror aaaaaa
    [bom.csv, designators.csv, positions.csv]
2025-03-17 ultrasound test example
    [AH-12026-045045-A1_931_v1.0.STEP, AH-21029-045045-01_712_v1.1.STEP]
2025-03-18 Remove auto saved files from top plate?
2025-03-18 Update bottom plate pinmap
2025-03-18 Add a bit of LEDs
2025-03-18 :sparkles: Initialize camera
2025-03-18 LEDD SHINY
2025-03-18 Do a bit more bottomplate pico
2025-03-18 IR not working, pls save us
    [main.cpp]
2025-03-19 ultrasonic.mofmofdetection move to external
2025-03-19 LEDs for top plate :O
2025-03-19 :sparkles: A lot of top plate source code done
2025-03-19 :pencil: top pico is done!!!!
2025-03-19 AHHHH try to fix a bunch of top plate
    [config.hpp, main.cpp]
2025-03-20 Write test for bottom pico
2025-03-20 Write source for top pico
2025-03-20 LEDs work except blue :(
2025-03-20 :fire: Update motor driver tests and lib
2025-03-21 edit top plate to make config less scuffed
2025-03-21 :sparkles: bottom plate source code done!
2025-03-21 :sparkles: Frame Processor
2025-03-22 edit motor driver tests to use motor::
2025-03-22 Make motor spin down
2025-03-23 more optimizations, down to 36ms
    [points_data.csv]
2025-03-23 Improve a few things with the cam localization
    [points_data.csv]
2025-03-24 :sparkles: Add ADC!
2025-03-24 :bug: fix a ton of bugs including heading overflow
    [main.cpp]
2025-03-25 :sparkles: A LOT OF BUGS FIXED I WANA BONK
    [main.cpp]
2025-03-25 pid sort of but not building cos max
2025-03-25 fix camera record
2025-03-25 MOTORS it prints the right values
2025-03-26 AHHHHH implement camera source
2025-03-26 fix in pins not working
    [main.cpp]
2025-03-26 WOOO IT WORKS MOTORS
2025-03-26 make line sensor and mouse sensor test work
2025-03-26 IT FRICKIJG WORKS BOTTOM PLATE!!!!! :D ADC
2025-03-26 actually working motor formula sriram
2025-03-27 :sparkles: Add ITRIP and OCP, refractor motor driver
2025-03-27 added setting of pid and vid
2025-03-27 Sync VID PID to top and middle
2025-03-27 fix camera loss generation issues
    [main.cpp]
2025-03-27 mcp23s17 refractored, adding interrupts now
2025-03-27 PID Works???
2025-03-27 AAAAAAHHHH MOUSE SENSOR
2025-03-27 ATTACH LISTENER FRICKING WORKS
2025-03-28 Edit attach listener so that we get to provide a device to attach a listener to
2025-03-28 fixed usb vid pid setting
    [config.hpp]
2025-03-28 added interrupts to MCP23S17
2025-03-28 Refractor the entire driver lib for thre new pins lib
2025-03-28 :sparkles: Refractor camera a bit ish and start on source code
2025-03-28 changed mcp23s17 to use log funcs and added detaching and disabling/enabling interrupts
2025-03-28 interrupts for digital pins done
2025-03-28 pins lib compiles i think? cant compile the test bcos adc not in motor driver lib or smth
2025-03-29 fix driver lib
2025-03-29 init in motor
2025-03-29 switch bcasse stupidness
2025-03-29 Finish bottom plate firmware kinda
2025-03-29 Potentially fix camera loc tilted thing
    [main.cpp]
2025-03-29 Partially Working Particle Filter
    Converges at right position but wrong heading, probably a matter of changing some weights
    [main.cpp]
2025-03-30 Update rpi and correct a few things
    [main.cpp]
2025-03-30 new motor driver update
2025-03-30 removed interrupts from pins
2025-03-31 Done adapting bottom plate
2025-03-31 Add wiringPi
2025-03-31 Wiring pi compiles
2025-03-31 Add ADC
2025-03-31 Fixed one wonky line in PID and a bit of goalpost detection
2025-03-31 try to fix for wiringpi
2025-03-31 wiringpi compiles for pi
2025-03-31 Find midpoints of quadrilaterals and shifted the file to the right place
    moved from middle to rpi-direct under libs >> camera >> scripts
2025-04-01 fix small bottom plate cannot build issue
2025-04-01 fix a lot of rpi and bottom bugs
    [main.cpp, mode_controller.cpp]
2025-04-01 fix a bunch of stuff on rpi
    [main.cpp, mode_controller.cpp]
2025-04-01 LOTS of bug fixes
    [main.cpp]
2025-04-01 Added IR ball detection
    Given the values for each sensor (numbers follow numbering in KiCad), finds the direction the bot must travel to reach the bot as well as the distacne. However, this distance is currently arbitrary cos have not calibrated yet.
2025-04-01 moved led to before wait for cdc connect
2025-04-01 Updated PF to get velocity from IMU rather than mouse sensor
2025-04-02 aaa fixed top imu
2025-04-02 Ball detection test (without LEDs)
2025-04-02 :sparkles: Rip comms::USB_CDC.printf :(
2025-04-02 Got bottom pico logs :D
2025-04-02 iT SPINS??? WRONG RPM
    [main.cpp]
2025-04-02 heh 2 issues now: motor driver intiialization randomly failing, and also wrong duty cycle sending?
    [main.cpp]
2025-04-02 Modify a bunch of printfs
2025-04-02 changed 1 for pid
2025-04-02 whatever ive done for IMU so far
2025-04-02 PID changes
2025-04-02 Fixed Position PID
2025-04-03 More PID Fixes, not this is not complete
2025-04-03 update middle plate
2025-04-03 IMU lib + fusion for correction
2025-04-03 imu calibration setup
2025-04-03 imu test
2025-04-03 i wan die
2025-04-03 AAAAH ANOTHER PID FIX
2025-04-03 This should probably be it for PID hopefully
2025-04-03 IMU stuff
2025-04-03 clauded imu calibration
2025-04-03 Integrate IMU into cam
2025-04-03 maybe motor accel limiting on pico
2025-04-04 reverted doing accels on pico side
2025-04-04 motor wrappers
2025-04-04 prob not the issue
    [main.cpp]
2025-04-04 Revert "it works now????"
    This reverts commit 29b77cca0a2c99cc15313248416ed3dde58fad4f.
    [main.cpp]
2025-04-05 button clicking to run exe or stop exe script
2025-04-05 optimised line sensors and decreased poll rate
2025-04-05 uhhh revert the funny
    [main.cpp]
2025-04-05 drivers actually work reliably??
2025-04-05 line sensor evade vectors
2025-04-05 line sensor evade
2025-04-05 line sensors dont recieve for some reason
2025-04-05 Fixing some cam stuff
    [main.cpp]
2025-04-05 Try to maek IR ball track work?
2025-04-06 fixed motors
2025-04-06 integrated defender logic with line sensor evasion
    resolve 2 vecs then add
    [main.cpp]
